FaradayRF/FaradayRF-Hardware/README.md

# FaradayRF-Hardware
This repository contains all necessary hardware files to build a Faraday radio. The design files include any engineering calculations as well as Kicad schematic, PCB, and library files.

## Kicad
Faraday was designed using the open source EDA tool Kicad. The specific version is listed below:
Version: (2013-07-07 BZR 4022)-stable

# Design Files
 * [Kicad Project](https://github.com/FaradayRF/FaradayRF-Hardware/blob/master/Kicad-Faraday/Faraday.pro)
 * [PDF Schematic](https://github.com/FaradayRF/FaradayRF-Hardware/blob/master/Kicad-Faraday/OutputFiles/FaradayRF-SCH.pdf)
 * [Fabrication Zip](https://github.com/FaradayRF/FaradayRF-Hardware/blob/master/Kicad-Faraday/OutputFiles/Faraday-RevD-FAB.zip)
   * Gerbers
   * Readme file
 * [Assembly Zip](https://github.com/FaradayRF/FaradayRF-Hardware/blob/master/Kicad-Faraday/OutputFiles/Faraday-RevD-ASSY.zip)
   * Top/Bottom copper, soldermask, solderpaste gerbers
   * Pick and place file
   * Readme file
  * [Bill of Materials](https://github.com/FaradayRF/FaradayRF-Hardware/blob/master/Kicad-Faraday/OutputFiles/Faraday-REVD(BOM).xlsx)
