FaradayRF/FaradayRF-Hardware/EngineeringDocs/ICD_REV_C.xlsx

Sheet: CC430 IO
PIN Name | Direction | Name | Function |  | Option
P1.0 | INPUT | GPS_PPS | GPS | Interrupt Enabled | GPS PPS
P1.1 | OUTPUT | UCB0CS2 | SPI | Interrupt Enabled
P1.2 | INPUT | UCB0_SOMI_SCL | SPI | Interrupt Enabled
P1.3 | OUTPUT | UCB0_SIMO_SDA | SPI | Interrupt Enabled
P1.4 | OUTPUT | UCB0CLK | SPI | Interrupt Enabled
P1.5 | INPUT | UCA0RXD | UART | Interrupt Enabled
P1.6 | OUTPUT | UCA0TXD | UART | Interrupt Enabled
P1.7 | INPUT | BUTTON_1 | IO/BTN | Interrupt Enabled
P2.0 | INPUT | GPS_UART_TX | GPS | Interrupt Enabled
P2.1 | ADC | ADC_6 | CC430_ADC | Interrupt Enabled | VCC Monitor
P2.2 | ADC | ADC_5 | CC430_ADC | Interrupt Enabled
P2.3 | ADC | ADC_4 | CC430_ADC | Interrupt Enabled
P2.4 | ADC | ADC_3 | CC430_ADC | Interrupt Enabled
P2.5 | ADC | ADC_2 | CC430_ADC | Interrupt Enabled
P2.6 | ADC | ADC_1 | CC430_ADC | Interrupt Enabled
P2.7 | ADC | ADC_0 | CC430_ADC | Interrupt Enabled
P3.0 | INPUT/OUTPUT | GPIO_2 | IO
P3.1 | INPUT/OUTPUT | GPIO_1 | IO
P3.2 | INPUT/OUTPUT | GPIO_0 | IO
P3.3 | OUTPUT | GPS_RESET | GPS
P3.4 | OUTPUT | GPS_STANDBY | GPS
P3.5 | OUTPUT | MEM_CS1 | FLASH
P3.6 | OUTPUT | LED_1 | Indicator
P3.7 | OUTPUT | LED_2 | Indicator
P4.0 | INPUT/OUTPUT | GPIO_7 | IO
P4.1 | INPUT/OUTPUT | GPIO_6 | IO
P4.2 | INPUT/OUTPUT | GPIO_5 | IO
P4.3 | INPUT/OUTPUT | GPIO_4 | IO
P4.4 | INPUT/OUTPUT | GPIO_3 | IO
P4.5 | OUTPUT | PA_ENABLE | RF
P4.6 | OUTPUT | LNA_ENABLE | RF
P4.7 | OUTPUT | HGM_SELECT | RF
P5.0 | SPECIAL | CC430_WATCH_XTAL_0 | XTAL | 32.768KHz | XIN
P5.1 | SPECIAL | CC430_WATCH_XTAL_1 | XTAL | 32.768KHz | XOUT
P5.2 | INPUT/OUTPUT | GPIO_8 | IO
P5.3 | OUTPUT | GPS_UART_RX | GPS
P5.4 | OUTPUT | MOSFET_CNTL | Actuation
P5.5 | OUTPUT | MEM_CS0 | SRAM
P5.6 | OUTPUT | MEM_HOLD0 | SRAM
P5.7 | OUTPUT | MEM_HOLD1 | FLASH

Sheet: POGO Test Points
Test Point | Function
TP1 | 3.3V
TP2 | 5V
TP3 | VCC
TP4 | VCC EXTERNAL
TP5 | AD0
TP6 | AD1
TP7 | AD2
TP8 | AD3
TP9 | AD4
TP10 | AD5
TP11 | IO0
TP12 | IO1
TP13 | IO2
TP14 | IO3
TP15 | IO4
TP16 | IO5
TP17 | IO6
TP18 | IO7
TP19 | IO8
TP20 | GPS PPS
TP21 | GPS Fixed
TP22 | MOSFET IN
TP23 | BUTTON

Sheet: PINS
PIN Number | Name | Status
1 | P1.7/ PM_UCA0CLK/ PM_UCB0STE/ R03 | NO
2 | P1.6/ PM_UCA0TXD/ PM_UCA0SIMO/ R13/ LCDREF | YES
3 | P1.5/ PM_UCA0RXD/ PM_UCA0SOMI/ R23 | YES
4 | LCDCAP/ R33 | NO
5 | COM0 | NO
6 | P5.7/ COM1/ S26 | YES
7 | P5.6/ COM2/ S25 | YES
8 | P5.5/ COM3/ S24 | YES
9 | P5.4/ S23 | YES
10 | VCORE | NO
11 | DVCC | YES
12 | P1.4/ PM_UCB0CLK/ PM_UCA0STE/ S22 | YES
13 | P1.3/ PM_UCB0SIMO/ PM_UCB0SDA/ S21 | YES
14 | P1.2/ PM_UCB0SOMI/ PM_UCB0SCL/ S20 | YES
15 | P1.1/ PM_RFGDO2/ S19 | YES
16 | P1.0/ PM_RFGDO0/ S18 | NO
17 | P3.7/ PM_SMCLK/ S17 | YES
18 | P3.6/ PM_RFGDO1/ S16 | YES
19 | P3.5/ PM_TA0CCR4A/ S15 | YES
20 | P3.4/ PM_TA0CCR3A/ S14 | YES
21 | P3.3/ PM_TA0CCR2A/ S13 | YES
22 | P3.2/ PM_TA0CCR1A/ S12 | YES
23 | P3.1/ PM_TA0CCR0A/ S11 | YES
24 | P3.0/ PM_CBOUT0/ PM_TA0CLK/ S10 | YES
25 | DVCC | YES
26 | P4.7/ S9 | YES
27 | P4.6/ S8 | YES
28 | P4.5/ S7 | YES
29 | P4.4/ S6 | YES
30 | P4.3/ S5 | YES
31 | P4.2/ S4 | YES
32 | P4.1/ S3 | YES
33 | P4.0/ S2 | YES
34 | P5.3/ S1 | YES
35 | P5.2/ S0 | YES
36 | RF_XIN | YES
37 | RF_XOUT | YES
38 | AVCC_RF | YES
39 | AVCC_RF | YES
40 | RF_P | YES
41 | RF_N | YES
42 | AVCC_RF | YES
43 | AVCC_RF | YES
44 | RBIAS | YES
45 | GUARD | YES
46 | PJ.0/ TDO | YES
47 | PJ.1/ TDI/ TCLK | YES
48 | PJ.2/ TMS | YES
49 | PJ.3/ TCK | YES
50 | TEST/ SBWTCK | NO
51 | ~RST~/NMI/SBWTDIO | NO
52 | DVCC | YES
53 | AVSS | YES
54 | P5.1/ XOUT | YES
55 | P5.0/ XIN | YES
56 | AVCC | YES
57 | P2.7/ PM_ADC12CLK/ PM_DMAE0/ CB7 (/A7) | YES
58 | P2.6/ PM_ACLK/ CB6 (/A6) | YES
59 | P2.5/ PM_SVMOUT/ CB5 (/A5/ VREF+/ VeREF+) | YES
60 | P2.4/ PM_RTCCLK/ CB4 (/A4/ VREF-/ VeREF-) | YES
61 | P2.3/ PM_TA1CCR2A/ CB3 (/A3) | YES
62 | P2.2/ PM_TA1CCR1A/ CB2 (/A2) | YES
63 | P2.1/ PM_TA1CCR0A/ CB1 (/A1) | YES
64 | P2.0/ PM_CBOUT1/ PM_TA1CLK/ CB0 (/A0) | YES
65 | VSS – Exposed pad | YES

Sheet: GPIO_Bitmask
 |  |  |  |  |  |  |  | Inputs
Hardware Defined OUTPUT's |  |  |  |  | Outputs |  |  | P1.0 | INPUT | GPS_PPS
GPIO OUTPUT Bitmask Array Byte | GPIO Bitmask Array Byte | Allocation Name | Port Allocation | Notes | P1.1 | OUTPUT | UCB0CS1 | P1.2 | INPUT | UCB0_SOMI_SCL
0 | 0 | UCB0CS1 | P1.1 |  | P1.3 | OUTPUT | UCB0_SIMO_SDA | P1.5 | INPUT | UCA0RXD
0 | 1 | UCB0_SIMO_SDA | P1.3 |  | P1.4 | OUTPUT | UCB0CLK | P1.7 | INPUT | BUTTON_1
0 | 2 | UCB0CLK | P1.4 |  | P1.6 | OUTPUT | UCA0TXD | P2.0 | INPUT | GPS_UART_TX
0 | 3 | UCA0TXD | P1.6 |  | P3.0 | OUTPUT | PA_ENABLE | P3.5 | INPUT | GPS_FIX_INDICATOR
0 | 4 | PA_ENABLE | P3.0 |  | P3.1 | OUTPUT | LNA_ENABLE
0 | 5 | LNA_ENABLE | P3.1 |  | P3.2 | OUTPUT | HGM_SELECT
0 | 6 | HGM_SELECT | P3.2 |  | P3.3 | OUTPUT | GPS_RESET
0 | 7 | GPS_RESET | P3.3 |  | P3.4 | OUTPUT | GPS_STANDBY
1 | 8 | GPS_STANDBY | P3.4 |  | P3.6 | OUTPUT | LED_1
1 | 9 | LED_1 | P3.6 |  | P3.7 | OUTPUT | LED_2
1 | 10 | LED_2 | P3.7 |  | P5.4 | OUTPUT | MOSFET_CNTL
1 | 11 | MOSFET_CNTL | P5.4 |  | P5.5 | OUTPUT | SRAM_CS
1 | 12 | SRAM_CS | P5.5 |  | P5.6 | OUTPUT | SRAM_HOLD
1 | 13 | SRAM_HOLD | P5.6
1 | 14 | TBD
1 | 15 | TBD
Hardware Defined Input |  |  |  |  | GPIO
GPIO INPUT Bitmask Array Byte | GPIO Bitmask Array Byte | Allocation Name | Port Allocation |  | P4.0 | TBD | GPIO_7
0 | 0 | GPS_PPS | P1.0 |  | P4.1 | TBD | GPIO_6
0 | 1 | UCB0_SOMI_SCL | P1.2 |  | P4.2 | TBD | GPIO_5
0 | 2 | UCA0RXD | P1.5 |  | P4.3 | TBD | GPIO_4
0 | 3 | BUTTON_1 | P1.7 |  | P4.4 | TBD | GPIO_3
0 | 4 | GPS_UART_TX | P2.0 |  | P4.5 | TBD | GPIO_2
0 | 5 | GPS_FIX_INDICATOR | P3.5 |  | P4.6 | TBD | GPIO_1
0 | 6 |  |  |  | P4.7 | TBD | GPIO_0
0 | 7
Hardware Defined GPIO
GPIO INPUT Bitmask Array Byte | GPIO Bitmask Array Byte | Allocation Name | Port Allocation
0 | 0 | GPIO_7 | P4.0
0 | 1 | GPIO_6 | P4.1
0 | 2 | GPIO_5 | P4.2
0 | 3 | GPIO_4 | P4.3
0 | 4 | GPIO_3 | P4.4
0 | 5 | GPIO_2 | P4.5
0 | 6 | GPIO_1 | P4.6
0 | 7 | GPIO_0 | P4.7

Sheet: ADC Memory Registers
ADC Memory | REF_LOW | REF_HIGH | ADC Channel | Faraday Channel | Port Pin | Note
ADC12MCTL0 | GND | Internal 2.5V Reference | AD_0 | Analog 7
ADC12MCTL1 | GND | Internal 2.5V Reference | AD_1 | Analog 6
ADC12MCTL2 | GND | Internal 2.5V Reference | AD_2 | Analog 5
ADC12MCTL3 | GND | Internal 2.5V Reference | AD_3 | Analog 4
ADC12MCTL4 | GND | Internal 2.5V Reference | AD_4 | Analog 3
ADC12MCTL5 | GND | Internal 2.5V Reference | AD_5 | Analog 2
ADC12MCTL6 | GND | Internal 2.5V Reference | AD_6 | Analog 1
ADC12MCTL7 | GND | Internal 2.5V Reference | AD_10 | MSP430 Temperature | Internal Temperature
ADC12MCTL8 | GND | Internal 2.5V Reference | AD_11 | MSP430 3.3V Vin | 3.3V | (AVCC-AVSS)/2
