FaradayRF/FaradayRF-Hardware/EngineeringDocs/Crystal_Calculations.xlsx

ABM8G-26.000MHZ-18-D2Y-T
CL | 18 | pF
CStray | 3 | pF | Assumption
C1 | 30 | pF
C2 | 30 | pF
Ccalc | 18 | pF
ST3215SB32768H5HPWAA
CL | 12.5 | pF
CStray | 3 | pF | Assumption
C1 | 18 | pF
C2 | 18 | pF
Ccalc | 12 | pF
