FaradayRF/FaradayRF-Hardware/EngineeringDocs/RF_Power_Test_RevB_11-19-2016.xlsx

CC430 Setting | Power Indicated | Power (dBm)
1 | -17.18 | -7.18
5 | -10.59 | -0.59
20 | -5.81 | 4.19
30 | 1.8 | 11.8
40 | 5.8 | 15.8
50 | 0.27 | 10.27
60 | 12.34 | 22.34
70 | 13.06 | 23.06
80 | 13.77 | 23.77
90 | 13.2 | 23.2
100 | 12.18 | 22.18
120 | 13.9 | 23.9
130 | 15.68 | 25.68
140 | 14.51 | 24.51
145 | 15.67 | 25.67
150 | 15.28 | 25.28
155 | 14.74 | 24.74
165 | 15.38 | 25.38
175 | 7 | 17
185 | 14.9 | 24.9
