FaradayRF/FaradayRF-Hardware/CHANGES.txt

# Please include a list of the changes you made to the original design by FaradayRF below
# Per TAPR OHL V1.0
