FaradayRF/FaradayRF-Hardware/(threads)

Thread 1 (2016-10-17):

Update Hardware From Revision B Design/Testing

kb1lqc, 2016-10-17:
Revision B hardware testing has identified several changes that would be ideal to incorporate with a board spin. Most of these are manufacturing related to help ensure a well designed PCB for production.

- [x] Change L10 to 22nH 0603 inductor
- [x] Check NUF2101MT1G (U10) footprint carefully
- [x] Check MIC94072YC6 (U12) footprint as it looks very close to solder bridge prone
- [x] Move Via near CC430 exposed pad which causes copper to be pulled back
- [x] Put Solder paste Layer on Q1
- [x] Double-check orientation of X2 versus datasheet and footprint/pinout
- [x] Consider changing R17 to 360 Ohms for stronger filter
- [x] Remove an RC filter from an ADC port to allow microphone use
- [x] Map GD0 to a pin for eventual use off-board @kb1lqd overview in #6
- [x] Validate USB Multiplexing & Negotiation Circuitry
- [x] Make sure antenna is located such that it doesn't hit DOUT headers
- [x] Verify flash memory hardware @kb1lqd
- [x] Update silkscreen markings to Rev C
- [x] Update Faraday logo + open logo
- [x] Crystal X2 silkscreen pin 1 indicator moved to printable area
- [x] Keep copper out of CC1190 keepout area
- [x] Pull back copper from C28 and C9

kb1lqc, 2016-10-18:
**Remove an RC filter from an ADC port to allow microphone use**

I have decided to remove ADC5 RC filter to allow use with a microphone or other needs for unaltered ADC input. To do this, I've simply placed a 2 Ohm resistor at R25 and DNP'd C48. This allows eventual modification to a normal RC low-pass filter or just a capacitor in place of R25 to create a high-pass filter if speech recognition is benefited from that. Using 2 Ohms essentially gives me a zero Ohm resistor without adding a BOM line item.

Frc = 1/(2*Pi*(2 Ohms) * (25pF)) = 3.18 GHz

The resonant frequency of the 2 Ohm jumper with the CC430 ADC input capacitance of 25 pF creates a low-pass filter at 3.18 GHz which means the CC430 will be unaffected by this resistor.

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

kb1lqc, 2016-10-18:
**Put Solder paste Layer on Q1**
I actually cannot see why this came up as an issue. Looking at the actual OSHStencil Q1 clearly has holes for solderpaste. The KiCad PCBNew module editor also clearly shows Q1 having "Front Solder Paste" layers on each pad.

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

Looking at the image I took of a Faraday Rev B PCB just after solderpaste application clearly shows Q1 not covered in solder paste. I think the culprit is that either I didn't push down hard enough with the squeegee card when applying solderapaste or the holes are too small.

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

Marking this is complete. Production boards will be professionally pick and placed.

kb1lqc, 2016-10-18:
**Consider changing R17 to 360 Ohms for stronger filter**
I hooked up a Faraday Rev B to an old HP 6205C bench PSU and set the voltage to 1.395V. Faraday vin reads up to about 2.41V with it's internal Vref so this is roughly in the middle of the range. The HP power supply is also not the quietest supply, especially with almost no load.

Capturing roughly 30 minutes of telemetry I observed on average 2 bits of noise. The peak noise of the 1Hz telemetry appears to be about +-3 bits. Using an internal CC430 Vref and not using a super stable PSU or external reverence voltage to generate a test voltage I'm considering the CC430 ADC's to work well.

kb1lqc, 2016-10-18:
**Map GDO to a pin for eventual use off-board**
@kb1lqd What do you mean by bringing GDO off the board? Given the [CC430 Family User's Guide](http://www.ti.com/lit/ug/slau259e/slau259e.pdf) the GDO pin might be able to be mapped to an external pin already.

Did you want Synchronous or Asynchronous support?

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

As it stands the GDO0 pin is on P1.0 which is currently used for GPS PPS signal.

- GDO0 = GPS PPS
- GDO1 = LED 1
- GDO2 = UCB0CS2

Are you sure we can't simply use the port mapper internally to the CC430 to move GDO0 to a IO pin such as on P4.x?

kb1lqc, 2016-10-18:
**Make sure antenna is located such that it doesn't hit DOUT headers**

- This comment/concern stems from the idea that we want to stack any custom PCBs or "shields" on-top of Faraday. This is not entirely true
 - It appears that if custom boards were put on-top they could fit just without connecting to D0, D1, or D2. The PCB would simply not be able to go past D3 or it would hit the antenna/SMA connector.

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

- However this isn't an issue if we simply assume that Faraday will always be the top PCB.
- We must make custom PCB/shields anyways, while Faraday is the same form-factor as an Arduino and will physically plug into an Arduino or Arduino compatible shield, our pinout is different. This was an honest decision we made Rev A to Rev B as the Arduino pinout greatly limited us.

> Marking this as solved and doing nothing. Stack any extra boards on the bottom or if they are stacked on the top then design in a cutout for the antenna. Moving the antenna is too big of a problem give 4 layers and the amount of IO routing in that area of the board.

kb1lqc, 2016-10-19:
**Validate USB Multiplexing & Negotiation Circuitry**

To check this circuit out I need to perform the following hardware changes
- DNP R7
- Populate U11
- Populate C15

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

Then I will need to configure the FTDI [FT PROG](http://www.ftdichip.com/Support/Utilities.htm#FT_PROG) to configure CBUS3 of U6 to be Power Enable. This will auto-configure into high power mode before turning on Faraday when plugged into a USB port. It's advantageous since this is USB compliant and overall causes less inrush.

kb1lqc, 2016-10-20:
Per my testing on #5 I've decided to use the FTDI USB negotiation and soft-start circuit. This ensures we are conservative with USB power on and minimize inrush events that could damage Faraday or damage a USB port powering Faraday.

I've removed R7 and populated C15 and U11 to perform the inversion necessary to have the FT230X control the MIC94072YC6.

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

kb1lqc, 2016-10-20:
**Move Via near CC430 exposed pad which causes copper to be pulled back**
Offending via shown below from Rev B build images
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

This is the GPS standby control signal. So low speed on/off and therefore can be routed however I need.
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

## Fixed
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

As shown above I routed the standby signal as well as two adjacent signals (HRST, P3_6) to move STDBY up to 15 mils from the CC430 center exposed pad. This should fix any issue of the copper being pulled back for the via.

kb1lqc, 2016-10-21:
# Check NUF2101MT1G footprint carefully

Looking at it I can't see what I thought was wrong? Looks fine... U10:
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

Comparing to the datasheet suggested land pattern:
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

## Pad Size
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

- Looks like the length Y is a bit longer than suggested but that's not really an issue here.
- X width is smaller than suggested
- all axis rotated 90 degrees so Y is left to right in footprint compared to my library footprint

This is likely due to me basing my footprint on one particular suggested footprint which differs from another vendor. This in general shouldn't be an issue for standard footprints such as this TSOP-6.

Checking pad spacing the Y spacing between pads it looks fine at 0.95mm. The X spacing is a little wide at 2.62mm but that's well within reason for having slightly longer pads to make up for that. This part will fit squarely on these pads.

kb1lqc, 2016-10-21:
# Check MIC94072YC6 (U12) footprint as it looks very close to solder bridge prone

U12 looks like it's a bit close to shorting between pins. There's almost no soldermask between pins! Maybe this is OK but whew...

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

## Footprint
This footprint is based on the Linear Technology [footprint for a SC70-6](http://cds.linear.com/docs/en/packaging/SOT_6_05-08-1638.pdf).

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

Pad Y: 1.00mm
Pad X: 0.47mm

This is exactly what the footprint wants. So looking at spacing now:

Pad Y Spacing: 1.8mm
Pad X Spacing: 0.65mm

This is also exactly what the LTC footprint asks for, copper looks good.

## Soldermask
It looks like OSHPark, who made the Rev B boards, has a minimum of 2.5 mil soldermask sliver for their prototype 4 layer boards. See their [specs](http://docs.oshpark.com/services/four-layer/). I'm going to assume OSHPark doesn't use a fancy process to make their boards (safe assumption) which means 2.5mils is 0.0635mm.

I measured 0.178mm between pads on my footprint model.
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

When looking at the PCB prior to populating it, the pads of U12 seem fine, there's a decent amount of soldermask there. I may see better results when the proper amount of solderpaste is applied, I likely used too much.

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

kb1lqc, 2016-10-21:
# Double-check orientation of X2 versus datasheet and footprint/pinout

The 26 MHz crystal, X2, on Faraday was originally placed backwards. This crystal is the [/ABM8G-10572](http://www.mouser.com/ds/2/3/ABM8G-10572.pdf). Here's the position on the board design:
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

and here is my initial placement which was 90 degrees off:
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

The top view looking down through the package as if the ceramic wasn;t present we should expect this pinout:
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

## Conclusion
It's obvious that my footprint agrees with the top view as it should, my orientation on the board is 180 degrees different but rotating the suggested footprint would result in the exact same, and correct, placement as I realized after populating the board.

Now why did I think I was right when populating at 90 degrees off? It appears that the chamfer can switch betwee pin 1 and pin 4, if the chamfer was on pin 4 instead of pin one then I would absolutely have placed the crystal the way I did.
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

## Solution
So this then comes down to not judging orientation by the chamfer. Instead if I simply ensure that my library footprint is [compliant with IPC-7351 Level A](https://blogs.mentor.com/tom-hausherr/blog/tag/ipc-standards/) then there is no need to look for the chamfer,
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

Keeping this orientation standard and using a pick and place machine results in either pin 1 being placed on pad 1 or with 180 degrees rotation in the tape and reel pin 3 would be placed on pad 1. This however is completely fine as pin 1 would connect to pad 3 and that still connects the crystal correctly.

Looking at my library I have pin 1 in the upper left quadrant 1 of the IPC spec. The datasheet shows the tape and reel orientation with long edges vertical when holding tape horizontal. According to the Mentor Graphics blog post oscillators (multi-pin) are in tape and reel packages with pin 1 in the lower left quadrant.

It seems like this is purely up to me telling the manufacturer that I follow IPC-7351 Level A with my footprints and that they should observe good judgment on tape an reel orientations. Worst-case the first batch of boards needs to be reworked and this is a pretty easy part to rework with a heat gun.

kb1lqc, 2016-10-24:
#  Map GD0 to a pin for eventual use off-board

Looking into this from @kb1lqd comments on #6, I will be using that Issue Ticket to track changes to the PCB. This is looking like it will absolutely be the biggest change to the entire board between Rev B and Rev C...

kb1lqc, 2016-10-25:
Confirming successful changes to Revision C hardware

- [x] Change L10 to 22nH 0603 inductor
_Inductor moved over to L0603 footprint_
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

- [x]  Check NUF2101MT1G (U10) footprint carefully
_Part looks fine on board_
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
- [x]  Check MIC94072YC6 (U12) footprint as it looks very close to solder bridge prone
_Checked out fine in previous comment about this footprint_
- [x]  Move Via near CC430 exposed pad which causes copper to be pulled back
_Looks good to me, my moved pulled it away from the pad even with further work in the area_
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
- [x]  Put Solder paste Layer on Q1
_Q1 is correctly solderpasted_
- [x]  Double-check orientation of X2 versus datasheet and footprint/pinout
_Orientation is fine per pin 1 having the chamfer. Professional pick and place should remove human eye coordination error._
- [x]  Consider changing R17 to 360 Ohms for stronger filter
_Keeping 2 Ohm resistor with standard 0.1uF decoupling capacitor. No need to change._
- [x]  Remove an RC filter from an ADC port to allow microphone use
_ADC5 replaced series resistance with 2 Ohm resistor while parallel capacitor DNP'd_
- [x]  Map GD0 to a pin for eventual use off-board @kb1lqd overview in #6

 - Pin 22: DIGITAL_IO_0
 - Pin 23: DIGITAL_IO_1
 - Pin 24: DIGITAL_IO_2
 - Pin 26: HGM_Select
 - Pin 27: LNA_Enable
 - Pin 28: PA_Enable

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

- [x]  Validate USB Multiplexing & Negotiation Circuitry
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
- [x]  Make sure antenna is located such that it doesn't hit DOUT headers
_Antenna nor does RF SMA cable become obstructed by IO headers when installed._
- [x]  Verify flash memory hardware @kb1lqd
@kb1lqd brought up the flash and was able to fix a [few initial errors](https://github.com/FaradayRF/Faraday-Firmware/issues/10) in his firmware to get it shaken out.
- [x]  Update silkscreen markings to Rev C
_Complete_
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
- [x]  Update Faraday logo + open logo
_Complete_
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

kb1lqc, 2016-10-25:
Checked all updates. Appear OK. Closing.

kb1lqc, 2016-10-26:
Documenting that running a Freedfm.com test caught a soldermask pullback error! The 0603 L10 component I placed in the CC1190 section is apparently missing a soldermask relief on the soldermask gerbers:

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

Yup, clearly visible. Will update!
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

kb1lqc, 2016-10-27:
Reopened to document several recent updates.

**X2 footprint updated to let Pin 1 silkscreen indicator print on PCB**
Was previously under pin 1 on C9 so it would never print
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

**U4 CC1190 Keepout Area Copper Pour Removed**
L10 moving to 0603 let copper pour under the keepout area. While this is fine, I want to not let this change happen from Rev B to Rev C.

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

**Copper Ground near C28 and L9 Pulled Back**
As shown in the image above of U4, you can see that the copper ground pour on the top layer no longer tries to fill in between the pads. I decided to keep the path of RF clear of any encroachments.

Closed 2016-10-27.

Thread 2 (2016-10-17):

Panelize PCB Design

kb1lqc, 2016-10-17:
Create standard panels with Faraday on them to reduce manufacturing costs, increase build efficiency, and increase yield.
- Panels should be sized such that more than one manufacturer can produce them
- Fiducials shall be placed on both unit PCBs and rails

Most work shall be completed in the [Production branch](https://github.com/FaradayRF/FaradayRF-Hardware/tree/Production) until it is ordered, then it will be moved over to Master.

kb1lqc, 2016-11-02:
Closing this until necessary, it appears most fabrication houses still tend to do this themselves.

Closed 2016-11-02.

Thread 3 (2016-10-17):

Move Hardware Files From SVN to GitHub

kb1lqc, 2016-10-17:
Reorganize the libraries and get the KiCAD 2013 project files to produce a correct ERC and DRC run on a standalone GitHub repository.

kb1lqc, 2016-10-17:
Closed issue as commit e1ad8f953297278cf41e22684335b58808a117df successfully brought the Revision B hardware files into GitHub!

Closed 2016-10-17.

Thread 5 (2016-10-19):

USB Power Testing

kb1lqc, 2016-10-19:
Testing performed to validate the design of the 5V USB power supply inrush limiting and USB compliance. Essentially, it's in our best interest to prevent Faraday from causing an inrush event when plugged in and ringing to over-voltage and destroy itself :white_check_mark:

kb1lqc, 2016-10-19:
I placed all my oscilloscope captures and a description PDF file into the Production branch Engineering Documents folder:

https://github.com/FaradayRF/FaradayRF-Hardware/tree/Production/EngineeringDocs/Oscilloscope_Captures/USB_Power_Testing

kb1lqc, 2016-10-19:
# 5V Input Transient
When connecting a Faraday to USB a rising edge inrush event occurs which will cause ringing with the capacitance and inductance on Faraday. The image below shows this inrush event measured with a low inductance ground lead for maximum signal accuracy.

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
-  Channel 1: Pin 1 of P16, microUSB connector VCC

Looking past ferrite bead Z2 we can see what signal the 5V rail of Faraday experiences
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
-  Channel 1: +5V Rail on Faraday

kb1lqc, 2016-10-19:
# MIC94072YC6 Performance
U12 limits inrush current by linearly turning on over the course of just about 1ms. This limits the charging current of bulk capacitance such as C17. All tests here performed with standard oscilloscope 6" ground clips to ground.

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
- Channel 1: +5V Rail
- Channel 2: Q3 Pin 3 (input to ideal diode)
It obvious that the IC works and took about 650uS to turn on which is pretty decent. Current into C17 certainly would be limited. The overvoltage spike present on the 5V rail does not make it past the ideal diode Q3.

For record, I plugged a 9V battery into Faraday via the VCC connector and then plugged in USB. As expected almost no current is drawn from USB so both +5V rail and Q3 pin 3 rise quickly as little voltage is dropped across U12 as it turns on.
- Channel 1: +5V Rail
- Channel 2: Q3 Pin 3 (input to ideal diode)
- Channel 3: C17 voltage to ground

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

I also performed a test where I left the 5V USB cable plugged in but then attached the 9V battery causing the ideal diode U2 (LTC3312) to reverse bias allowing the 9V to take over powering Faraday seamlessly. Same oscilloscope channel connections.
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

## USB Power to TPS562201DDCR Vin
A full end-to-end test showing the turn-on of power to U3 TPS562201 regulator input.

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
- Channel 1: +5V Rail
- Channel 2: Q3 Pin 3 (input to ideal diode)
- Channel 3: C17 voltage to ground

It's clear that the inrush current is in-fact limited and soft-start works well. Not totally sure it's USB compliant but it's a good effort for sure.

kb1lqc, 2016-10-19:
# FTDI FT230X CBUS PWREN Function
The FTDI FT230X allows you to use FT PROG to program the CBUS pin functions. Therefore I populated U11 and C15 while DNP R7 to allow CBUS3 to control the inrush limiter U12.

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

The scope capture below shows the USB negotiation occurring which after about 200ms the FT230X commands CBUS3 to enable U12 on. It's working!
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
- Channel 1:+5V
- Channel 2: Q3 pin 3
- Channel 3: VCC V17 voltage to GND

Zooming out a bit it's apparent the computer is generating some noise on Channel 1 (yellow) and after roughly four seconds it settles down. It does not appear that the noise makes it passed the ideal diode into C17, or it's at least filtered out a bit.
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
- Channel 1:+5V
- Channel 2: Q3 pin 3
- Channel 3: VCC V17 voltage to GND

Finally moving into a zoomed in position to take a look at the turn-on even when the FTDI FT230X enables the USB high power to occur. It's apparent that the output of U12, Q3 pin 3 and C17 float up to about 2V given U12 has some leakage current through it even when it's off.
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
- Channel 1:+5V
- Channel 2: Q3 pin 3
- Channel 3: VCC V17 voltage to GND

kb1lqc, 2016-10-19:
# Important Note About USB Power Negotiation
:exclamation: I realized that if Faraday uses USB negotiation then when it is plugged into a USB battery pack there is no computer to negotiate with.

Testing this with my Goal Zero Lighthouse Mini (lantern with USB output) I definitely see about 2V across C17 even well after turn-on. This configuration prevents Faraday from working with USB battery packs, however, 9V batteries on VCC would work fine.

kb1lqc, 2016-10-20:
I tested the leakage of the MIC94072YC6 when commanded to be off. To do this I plugged it into my Goal Zero USB battery pack which does not perform USB negotiation.

U12 Pin 3: 5.1V
U12 Pin 4 5.1V
U12 Pin 1: 1.395V

Clearly the MIC94072YC6 is being commanded off but it is not fully off. When I short Q3 pin 3 to ground through a multimeter I measure about 11mA which is not what the datasheet says it should be doing. Interesting.

kb1lqc, 2016-10-20:
> OK after much thought I'm going to keep the MIC94072YC6 and LTC4412 but use the USB configuration method. U12 seems capable of leaking 11mA when commanded off which could be a measurement error by me (poor solder?) but regardless this isn't an issue as we do not plan to support USB battery packs when 9V batteries are easily supported.

## USB 2.0 Inrush Specification
[USB Inrush Current](http://www.testusb.com/inrush_issue.htm) is nicely worded at the provided link. Faraday by design will initially place 1.3uF of capacitance on the VUSB pin to GND when attached. This is well below the 10uF limit and while I don't have the equipment to test inrush this is a good indicator that Faraday would pass.

Roughly 250ms after connection to power as shown below, Faraday negotiates into PWREN mode from the FT230X which turns on U12 allowing the >10uF present downstream from U12 to be connected to USB power with a ~800uS turn on soft-start. The USB specification requires no device to sink more than 100mA after inrush for at least 100ms which means by design Faraday is compliant with this USB 2.0 power specification.

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

## Automatic Power Detection
It's worth noting that the USB specification actually requires at least 1uF capacitance on VBUS in Section 7.2.4.2 so that a minimum inrush event is guaranteed. This allows devices to be detected if they are connected so they can turn on the circuitry that is powering the peripheral such as Faraday.

kb1lqc, 2016-10-20:
Completed my USB and power multiplexing tests I intended on this issue. I performed others off the record prior to starting this GitHub to ensure proper design as well.

Closed 2016-10-20.

Thread 6 (2016-10-23):

Synchronous/Asynchronous CC430 Radio Support

kb1lqd, 2016-10-23:
# Overview
It is likely that in the future Faraday will split into two main projects:
- A smart node digital radio with radio and communication processes controls on the CC430
- A (mostly) dumb radio module that allows a more powerful processor perform the communications such as a Raspberry Pi. Interactions with Faraday in this mode would largely be that of a raw modem interface through UART/SPI/CC1101 GDx pins

Texas Instruments provides a basic overview of the radio operations possible with the CC430: [http://www.ti.com/lit/an/slaa465c/slaa465c.pdf](http://www.ti.com/lit/an/slaa465c/slaa465c.pdf)

The example RF code is located here: [http://www.ti.com/lit/zip/slac525](http://www.ti.com/lit/zip/slac525)

## Actions

Since all the default port mapping is used for RF GDx pins and it's a secondary function we should implement port mapping. Port mapping is supported on P1, P2, and P3. We should swap 3 of the GPIO pins using port 4 with port 3 pins to allow a GPIO pin to become an RF GD0 pin.

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

Swap with basic I/O pins used on GPS and other devices:

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

Recommend swapping:

4.0 <-> 3.2
4.1 <-> 3.3
4.2 <-> 3.4

This **Should** allow for low risk swapping and peripheral operation while allowing a port mapped GDx signals to the external pins.

# Details

## Hardware Packet Handling (Less Than/Greater Than FIFO)

No changes needed, all of this is handled in the firmware. Key points:

- Really simple 64 byte FIFO operation
- Capability to have unlimited packet size operation
- Must still use general packet hardware structure and sync headers

## Synchronous/Asynchronous Operations

Synchronous/Asynchronous operation allows for direct access to the CC1101 radio core. This allows for the most flexibility in radio protocols as well as the ability to perform low level protocol processing on a more powerful platform.

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

### Asynchronous

Requires the use of internal timers.

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

### Synchronous

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

# Port Mapping

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

# Radio GD0 Pins

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

# Examples

Clock timer output to 2.7
Data output 2.6

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

The CC430 header file snippet above shows Port 3 but Port 2 is the same.

kb1lqc, 2016-10-24:
Upon inspection, I'd much rather use signals already traveling to the general CC1190 and GPIO pin area so I minimally affect my routing scheme. This means initially I'd like to perform the following IO changes:

- P3.0 to P4.5
- P3.1 to P4.6
- P3.2 to P4.7

This forces the CC1190 control signals to be moved over to GPIO channels. Since these signals generally route to the same area of the PCB this then results in minimal impact to the design.

kb1lqd, 2016-10-24:
@kb1lqc OK that makes sense. I should double check that all P4 GPIO do infact work as intended.

kb1lqc, 2016-10-24:
OK I updated and swapped the mentioned P3 and P4 signals. This was much easier to route since the channels all went to the same area of the PCB. This was changed in 4786a6094c6b3ada832c1a492106f61978195773.

kb1lqc, 2016-10-27:
Closing this issue as it was addressed in Issue #1

Closed 2016-10-27.

Thread 7 (2016-10-24):

Update Bill Of Materials For Rev C

kb1lqc, 2016-10-24:
KiCad provides a CSV output for the BOM but it needs to be updated to the latest changes. This should not be affected by panelization.

kb1lqc, 2016-10-24:
Updated most components in Rev C BOM to reflect the actual design as it currently stands. https://github.com/FaradayRF/FaradayRF-Hardware/commit/b83846a14831a8f30512f1a6c8d7647d2e71f8d7 holds the most current status of the BOM which needs a few more items actually sourced from vendors.

kb1lqc, 2016-10-27:
Updated a few components such as L10 and changed USB cable to one from Amazon.

Closed 2016-10-27.

Thread 8 (2016-10-26):

Validate Rev C Gerbers

kb1lqc, 2016-10-26:
Check Rev C Gerbers against Rev B Gerbers to make sure any and all differences are accounted for. The quickest way to do this is to use GerbV to XOR Rev B and Rev C, leaving the differences highlighted.

- [x] Faraday.drl
- [x] Faraday-B_Cu.gbl
- [x] Faraday-B_Mask.gbs
- [x] Faraday-B_Paste.gbp
- [x] Faraday-B_SilkS.gbo
- [x] Faraday-drl_map.pho
- [x] Faraday-Dwgs_User.gbr
- [x] Faraday-Eco1_User.gbr
- [x] Faraday-Eco2_User.gbr
- [x] Faraday-Edge_Cuts.gbr
- [x] Faraday-F_Cu.gtl
- [x] Faraday-F_Mask.gts
- [x] Faraday-F_Paste.gtp
- [x] Faraday-F_SilkS.gto
- [x] Faraday-InnerA_Cu.gbr
- [x] Faraday-InnerB_cu.gbr
- [x] Faraday-NPTH.drl
- [x] Faraday-NPTH-drl_map.pho

kb1lqc, 2016-10-26:
**Faraday.drl**
Differences from Rev B to Rev C
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

- It's clear that the only holes to change were related to the via's moved around to route the RF control signal lines and GPIO lines for GD0, GD1, and GD2. These changes moved lines for
 - P3.0, P3.1, P3.2, P4.5, P4.6, P4.7

_Faraday.drl looks good_

kb1lqc, 2016-10-26:
**Faraday-B_Cu.gbl**

Rev B to Rev C differences
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

- It appears that only the area involving the GDx signals between P3 and P4 on the MSP430 moved.
- Honestly, I think Rev C looks cleaner! (orange)

_Faraday-B_Cu.gbl looks good_

kb1lqc, 2016-10-26:
**Faraday-B_Mask.gbs**
Changes from Rev B to Rev C
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
- No observable changes for bottom soldermask which is good because I didn't change anything that would affect that.

_Faraday-B_Mask.gbs looks fine_

kb1lqc, 2016-10-26:
**Faraday-B_Paste.gbp**
Rev B to Rev C changes
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
 - No observable changes, changed nothing.

_Faraday-B_Paste.gbp looks good_

kb1lqc, 2016-10-26:
**Faraday-B_SilkS.gbo**
Rev B to Rev C changes
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
- FaradayRF and Rev B changed
 - This is ideal since I moved both texts to the front silkscreen and updated Rev b to Rev C

_Faraday-B_SilkS.gbo looks good_

kb1lqc, 2016-10-26:
**Faraday-drl_map.pho**
Rev B to Rev C changes
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
- Only drill holes associated with GDx pin changes observed as expected.

_Faraday-drl_map.pho looks good_

kb1lqc, 2016-10-26:
**Faraday-Dwgs_User.gbr**
Rev B to Rev C changes
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
- No changes to the drawing data as expected.

_Faraday-Dwgs_User.gbr looks good_

kb1lqc, 2016-10-26:
**Faraday-Eco1_User.gbr**
Rev B to Rev C changes
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
- Compenent courtyards for several devices changed.
 - Removed R7 near power supply previously used for soft-start enable switching
 - Changed out L10 near CC1190 circuit from 0402 to an 0603 component. Also had to move an adjacent part sideways slightly to fit the larger package.

_Faraday-Eco1_User.gbr looks good_

kb1lqc, 2016-10-26:
**Faraday-Eco2_User.gbr**
Rev B to Rev C changes
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

- No observable changes, good since I didn't change anything on this layer which is the path of the drill bit used to cut the boards out with tabs.

_Faraday-Eco2_User.gbr looks good_

kb1lqc, 2016-10-26:
**Faraday-Edge_Cuts.gbr**
Rev B to Rev C changes
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
- Nothing as I did not change the board dimensions from Rev B to Rev C

_Faraday-Edge_Cuts.gbr looks good_

kb1lqc, 2016-10-26:
**Faraday-F_Cu.gtl**
Rev B to Rev C Updates
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
- Several changes observed
 - R7 near the power supply soft start on the top left of the PCB has been removed in Rev C
 - The ADC lines in the bottom right were tidied up just slightly

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
Zooming in on the RF section:
- The GPIO lines as well as RF configuration signal lines were updated to help route GDx signals.
- L10 updated to an 0603 package which did allow copper to pour under the CC1190's bottom right corner. I happen to remember this area being a keepout. However, since no exposed copper or vias are in this keepout range I don't expect any issues.
 - :exclamation: On a similar note, I now have copper pouring beneath L10 which I don't trust. I'd like to keep copper from pouring underneath inductors. Provide keepout to prevent copport from pouring below

_Faraday-F_Cu.gtl **needs updating**_

kb1lqc, 2016-10-26:
**Faraday-F_Mask.gts**
Rev b to Rev C changes
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
- It's obvious from previous comments that the only differences here are the power supply soft start resistors removal and the L10 update to an 0603 component.

_Faraday-F_Mask.gts looks good_

kb1lqc, 2016-10-26:
**Faraday-F_Paste.gtp**
Rev B to Rev C Updates
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
- Changes again only appear in the regions of the soft-start resistor removal and the L10 upgrade in the RF amplifier section

_Faraday-F_Paste.gtp looks good_

kb1lqc, 2016-10-26:
**Faraday-F_SilkS.gto**
Rev B to Rev C upgrades
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
- Changes observed line up with good edits to the board
 - R7 has been removed so the reference designator will go too
 - L10 and C30 moved, including L10 increasing to 0603 footprint.
- Faraday name and Rev. C marking moved to top-middle of PCB
- OSHW logo and Faraday logo moved to middle of board and updated.
 - Old Faraday logo removed.

_Faraday-F_SilkS.gto looks good_

kb1lqc, 2016-10-26:
**Faraday-InnerA_Cu.gbr**
Rev B to Rev C updates
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
 - Changes line-up with via's used for GDx rerouting between GPIOs and RF switches

kb1lqc, 2016-10-26:
**Faraday-InnerB_cu.gbr**

Rev B to Rev C changes
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

- Again, changes consistent with new via locations near CC430 and RF section

_Faraday-InnerB_cu.gbr looks good_

kb1lqc, 2016-10-26:
**Faraday-NPTH.drl**
Rev B to Rev C changes
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
- No observable changes for inner layer A

_Faraday-NPTH.drl looks good_

kb1lqc, 2016-10-26:
**Faraday-NPTH-drl_map.pho**
Rev B to Rev C changes
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
- No observable changes

_Faraday-NPTH-drl_map.pho looks good_

kb1lqc, 2016-10-27:
Checking top layer and silkscreen after working with pick and place files resulted in a silkscreen change on X2 and in general want to make sure my footprints didn't change unexpectedly.

# Top Layer Rev B to Rev C
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

* Overall looks like nothing changed I didn't already go over
  * R7 near power supplies
  * ADC lines tidied up
  * GPIO and RF control signals rerouted
  * Copper near L10, C28, and L9. I know I didn't pull back from C29 but signal already split and I can only be so OCD...

# Rev B to Rev C Front Silkscreen
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
* L10 appears fine and 0603 with adjacent passive moved slightly right
* R7 removed

# Rev B to Rev C Front Solderpaste
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

* Changes as expected with L10 increased to 0603 and R7 removed.
* No other footprint changes seen

# Rev B to Rev C Front Silkscreen
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

* As expected reference designators for L10 and C30 moved with increase to L0603
* Faraday logo updated and OSHW added
* Faraday Rev and name updated
* X2 pin 1 indicator dot moved

kb1lqc, 2016-10-27:
Created final gerber (non-panelized) files and checked known changes. Looks good.

Closed 2016-10-27.

Thread 9 (2016-10-27):

Check Pick and Place Files

kb1lqc, 2016-10-27:
Ensure orientation makes sense. Verify library IPC pin 1 orientation and ensure output file makes sense to rotation file. I have used this [blog post](https://blogs.mentor.com/tom-hausherr/blog/tag/ipc-standards/) from Tom Hausherr at Mentor Graphics as a guideline for my library management process.

:warning: Moved over to Faraday.mod library from old KB1LQC.mod library due to incomplete library references. This ensures latest footprints are being used and only those that are inspected hardware tested are being used.

**IPC-7351B Zero Rotation** means that two pin passives always have zero rotation with pin 1 on the left, diodes have pin 1 (cathode) on the left. IC packages always have zero rotation pin 1 located in upper left quadrant. This standard allows the assembler to relate tape and reel orientation to PCB library rotation.

# IPC-7351B Zero Rotation
- [x] C0402
- [x] C0603
- [x] R0402
- [x] L0402
- [x] L0603
- [x] L0805
- [x] RGC
- [x] RGV
- [x] LGL29K
- [x] LPS4018
- [x] 22232021
- [x] 10118192-0001LF
- [x] SOT23-NXP
- [x] TSOT23-6
- [x] SF2049E
- [x] QFN-16-4x4
- [x] M10478-A2
- [x] TSSOP8
- [x] SOIC8-150MIL
- [x] SOT753
- [x] SC70-6
- [x] 0915BM15A0001E
- [x] ST3215SB32768H5H
- [x] ABM8G

# Faraday-all.csv Orientation
Checking each type of component to make sure orientation file makes sense
- [x] C0402
- [x] C0603
- [x] R0402
- [x] L0402
- [x] L0603
- [x] L0805
- [x] RGC
- [x] RGV
- [x] LGL29K
- [x] LPS4018
- [x] 22232021
- [x] 10118192-0001LF
- [x] SOT23-NXP
- [x] TSOT23-6
- [x] SF2049E
- [x] QFN-16-4x4
- [x] M10478-A2
- [x] TSSOP8
- [x] SOIC8-150MIL
- [x] SOT753
- [x] SC70-6
- [x] 0915BM15A0001E
- [x] ST3215SB32768H5H
- [x] ABM8G

kb1lqc, 2016-10-27:
Completed all footprints look good with new Faraday.mod library.

Closed 2016-10-27.

Thread 11 (2016-10-30):

Validated Rev C Gerbers #2

kb1lqc, 2016-10-30:
Check Rev C Gerbers against Rev B Gerbers to make sure any and all differences are accounted for. The quickest way to do this is to use GerbV to XOR Rev B and Rev C, leaving the differences highlighted.

I needed to change the gerbers to account for Advanced Circuits stackup which changed the 50 Ohm and 100 Ohm traces as well as forced the pullback of some copper ground planes. I also noticed that I had to change a few via's back to 13 mil holes but that didn't show up on the last attempt. Wierd.
- [x] Faraday.drl
- [x] Faraday-B_Cu.gbl
- [x] Faraday-B_Mask.gbs
- [x] Faraday-B_Paste.gbp
- [x] Faraday-B_SilkS.gbo
- [x] Faraday-drl_map.pho
- [x] Faraday-Dwgs_User.gbr
- [x] Faraday-Eco1_User.gbr
- [x] Faraday-Eco2_User.gbr
- [x] Faraday-Edge_Cuts.gbr
- [x] Faraday-F_Cu.gtl
- [x] Faraday-F_Mask.gts
- [x] Faraday-F_Paste.gtp
- [x] Faraday-F_SilkS.gto
- [x] Faraday-InnerA_Cu.gbr
- [x] Faraday-InnerB_cu.gbr
- [x] Faraday-NPTH.drl
- [x] Faraday-NPTH-drl_map.pho

kb1lqc, 2016-10-30:
# Faraday.drl

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

* Changes are exactly where I'd expect them to be
* Fixed some wierd holes like vias for the ADC RC filters that had gone to 10 mil drills from 13 but weren't on the last gerber attempt...

kb1lqc, 2016-10-30:
# Faraday-B_Cu.gbl

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
* Only GD0 and RF control routing changed on bottom layer as expected
* Rev B changed to Rev C on outside of board edge markings

kb1lqc, 2016-10-30:
# Faraday-B_Mask.gbs

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

* No changes to bottom layer soldermask as expected from Rev B to Rev C

kb1lqc, 2016-10-30:
# Faraday-B_Paste.gbp

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

* No change to bottom solder paste layer as expected

kb1lqc, 2016-10-30:
# Faraday-B_SilkS.gbo
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

* Faraday and Rev B markings removed from bottom silkscreen layer

kb1lqc, 2016-10-30:
# Faraday-drl_map.pho
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
* Drill map shows only changes in GD0 and RF control area.
* not shown on here is the drill map hole count showing two less 13 mil via's on Rev C, I removed two from the RF SMA connector to keep the ground away from RF microstrip traces.

kb1lqc, 2016-10-30:
# Faraday-Dwgs_User.gbr
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

* Only changes on drawings layer are stackup notes for Advanced Circuits stackup changes from previous OSHPark stackup.

kb1lqc, 2016-10-30:
# Faraday-Eco1_User.gbr

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
* R7 in power supply area was removed as expected
* Rev B to Rev C marking outside of board area also updated as expected
* ADC lines moved to be a more organized layout
* 100 Ohm and 50 Ohm traces on top layer from CC430 changed due to Advanced Circuits 4 layer PCB stackup
* Ground copper pulled away from top layer pour near 50 Ohm RF transmission lines
* GPIO traces moved along with RF control traces for GD0 update as expected

kb1lqc, 2016-10-30:
# Faraday-F_Mask.gts
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
* R7 in power supply area changed as expected
* L10 and nearby component moved so the soldermask moded too

kb1lqc, 2016-10-30:
# Faraday-F_Paste.gtp
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
* Same as soldermask, solderpast changed only for R7 in the power supply section and the RF L10 section

kb1lqc, 2016-10-30:
# Faraday-F_SilkS.gto
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
* R7 and L10 area's changed as expected for changed component placement
* Old Faraday logo removed
* New Faraday logo + OSHW logo added
* TAPR OHL text added
* Faraday and Rev C text added

kb1lqc, 2016-10-30:
# Faraday-InnerA_Cu.gbr
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
* Only changes on this layer, which is a solid groundplane, are those required with moved via's in the area of GPIO and RF control traces moved for GD0 modifications.
* Removed ground via's at SMA connector don't show up here since ground via's don't have groundplane layer pullback.
* Rev B text updated to Rev C outside of board edge area.

kb1lqc, 2016-10-30:
# Faraday-InnerB_cu.gbr
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
* Rev B text outside of board area changed to Rev C
* 50 Ohm trace changed size for Advanced Circuit stackup, ground pour pulled away too.
* Via's for control traces of GPIO and RF CC1190 moved as needed for GD0 update

kb1lqc, 2016-10-30:
# Faraday-NPTH.drl
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
* No changes to non-plated through holes as expected

kb1lqc, 2016-10-30:
# Faraday-NPTH-drl_map.pho
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
* As expected no changes to the non-plated through-hole layer means no changes to the map either!

kb1lqc, 2016-10-30:
# Faraday-Eco1_User.gbr
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

* Eco Layer 1 shows rough component courtyards and as expected R7 was removed and the components areound L10 also moved due to 0603 footprint change.

kb1lqc, 2016-10-30:
# Faraday-Eco2_User.gbr
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
* Eco Layer 2 is used for external tab routing drawings, no changes as expected

kb1lqc, 2016-10-30:
# Faraday-Edge_Cuts.gbr
* Not worth putting image here as there's literally nothing to show, no changes to the board shape or size from Rev B to Rev C

kb1lqc, 2016-11-02:
Files checked out OK.

Closed 2016-11-02.

Thread 13 (2016-11-02):

Kicad_pcb file breaks Macrofab Parser

kb1lqc, 2016-11-02:
When trying to upload the kicad_pcb file directly to macrofab to get quotes, the parser would fail. Thanks to their help it was identified as a single quote around line 7,288 in

Commit: https://github.com/FaradayRF/FaradayRF-Hardware/commit/0bd3c28bf71e9eca5ecc376e44965096ef62eabf

Error
```
(gr_text "0.063\" +- 10%" (at 294.64 127.762) (layer Dwgs.User)
    (effects (font (size 1.5 1.5) (thickness 0.3)))
```
This text is on my drawings layer for the PCB stackup. It appears that the escape used for the quote isn't dealt with nicely in the parser.
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

kb1lqc, 2016-11-02:
OK, Macrofab now uploads successfully withou the quote. Complete.

Closed 2016-11-02.

Thread 14 (2016-11-02):

Test GPS Without Ferrite Inductors and Capacitors

kb1lqc, 2016-11-02:
The GPS is a prime spot to remove components from. We may not actually need the 900MHz RF protection ferrites and capacitors.

**Inductors**
- [x] L23
- [x] L6
- [x] L20
- [x] L21
- [x] L22

**Capacitors**
- [x] C24
- [x] C55
- [x] C68
- [x] C69
- [x] C70

**Testing in Hardware on Rev B**
- [x] Tested

Basic testing of removing these parts or shorting around them and verifying that when transmitting the GPS remains locked is a good real-world test.

kb1lqc, 2016-11-03:
Tested at full power (152 in Balloon Flight Software/Firmware) without capacitors but with all inductors and GPS lock was achieved. 1Hz telemetry transmission interval over RF was the fastest I could have it do with this firmware.

kb1lqc, 2016-11-03:
GPS lock achieved with inductors and capacitors removed! Tried removing antenna to cause reflections which didn't affect the GPS lock (quality = 2) either. Placed my hand on the RF section to increase parasitics as well as handled the GPIO circuitry to try to mess it up with skin conduction but it remained locked.

Was transmitting at full power (152) with the HAB flight software/firmware. The only think I didn't try was bring a second Faraday super close to this Faraday. Since they all operate on similar frequencies this seems unlikely to cause an issue.

kb1lqc, 2016-11-10:
Moved to RevD branch. Removed the following:

**Inductors**
- [ ]  L23
- [ ]  L6
- [ ]  L20
- [ ]  L21
- [ ]  L22

**Capacitors**
- [ ]  C24
- [ ]  C55
- [ ]  C68
- [ ]  C69
- [ ]  C70

Closed 2016-11-03.

Thread 15 (2016-11-02):

Remove GPS Lock LED

kb1lqc, 2016-11-02:
We actually don't need this. Additionaly, we could hook it back up to an interrupt driven IO pin and flash the main LED or at least indicated in telemetry with or without the Fixed indicator pin.

- [x] R23
- [x] D8

kb1lqc, 2016-11-02:
Decided to DNP R23 and D8

kb1lqc, 2016-11-03:
I shouldn't have to test this. It's pretty self-evident and there should be zero issues from DNPing these parts simply by design.

kb1lqc, 2016-11-10:
Rev D Branch will have these removed. They are simply not necessary. We can detect a GPS lock with the CC430 UART and blink an LED we already have if necessary.

kb1lqc, 2016-11-10:
Removing:
- [x] D8
- [x] R23

Closed 2016-11-10.

Thread 16 (2016-11-02):

Remove GPS RF Capacitor C66

kb1lqc, 2016-11-02:
Since it appears we don't actually need to tune this antenna why not simply directly connect copper between pins 4 and 6 of the M104780A2 GPS? Remove inductors for tuning while I'm at it.

- [x] C66
- [x] L18
- [x] L19
- [x] Tested

kb1lqc, 2016-11-03:
Tested with C66 bypassed using wire (definitely conservative at 1.5GHz...

L18 and L19 DNP already so this is promising. Closing.

kb1lqc, 2016-11-10:
Used clean Master branch to create RevD branch which starts fresh.

Removed

- [x] C66
- [x] L18
- [x] L19

Closed 2016-11-10.

Thread 19 (2016-11-02):

Remove or Make ADC Filters Easily Solderable

kb1lqc, 2016-11-02:
The ADC filters are quite a few parts that we should either move to easily solderable components or remove them. This is a tricky one...

- [ ] R24
- [ ] C47
- [ ] R25
- [ ] C48
- [ ] R26
- [ ] C49
- [ ] R27
- [ ] C50
- [ ] R28
- [ ] C51
- [ ] R29
- [ ] C52
- [ ] R30
- [ ] C53

kb1lqc, 2016-11-03:
I removed R25 and C48 of ADC5, bridging over R25 to short across the contact effectively directly tapping into the ADC pin. I then took a piece of 6 inch wire and stuck it into ADC4 which still had the Low Pss RC filter to plot this 2 minute long graph of the wire allowing noise into the ADC4 channel.

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

Looking at ADC5 which has no Low Pass Filter, a six inch wire plugged into it conducted noise into the ADC5 pin which is clearly evident without a filter.

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

Testing performed with HAB flight firmware/software.

kb1lqc, 2016-11-03:
Oh boy, actually it makes sense to make ADC2 the microphone ADC input since it's also the external positive voltage reference pin.

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

I'll create an issue to update this pin in the design.

kb1lqc, 2016-11-10:
I adressed the move to ADC2 with the microphone/Vref input in #23. This is present on the RevD branch. Otherwise **I'm choosing to leave the ADC filters on all other channels.**

Closed 2016-11-10.

Thread 20 (2016-11-02):

Remove AVCC RC Filter And Low Frequency Crystal

kb1lqc, 2016-11-02:
The ADC AVCC filter isn't really needed, just keep the decoupling capacitor. We never really use the low frequency watch crystal X1 (32.768 KHz). Should DNP that.

- [x] R17
- [x] C7
- [x] C8

**Testing**
- [x] Testing

kb1lqc, 2016-11-02:
R17 removed

kb1lqc, 2016-11-03:
Tested Faraday with HAB Flight software/Firmware with R17 removed/shorted, worked fine as expected. Leaving C7 decoupling capacitor on.

kb1lqc, 2016-11-03:
Removed C7 and C8 without what appears to be any affect. Hard to measure frequency with an oscilloscope probe as it appears to be pretty low amplitude and the probe will likely be affecting the signal anyways. Would be best to use a counter internal to the CC430 to check this frequency but @kb1lqd says there are internal capacitors that can help mitigate issues we see. I'll DNP instead of removing anyways.

To test this we could just count the cycles based on X1 and divide by 32768, then trigger an IO pin. If we are anywere near 1Hz edges then this is pretty spot on.

kb1lqc, 2016-11-10:
Moved to RevD, DNPd:

- [ ] C7
- [ ] C8

kb1lqc, 2016-11-10:
Also removed AVCC filter resistor:

- [ ] R17

Closed 2016-11-10.

Thread 21 (2016-11-02):

Remove Button and LED 2

kb1lqc, 2016-11-02:
The button has rarely seen actual use and the second LED is nice but maybe we could DNP it or remove it entirely.

- [x] BTN1
- [x] R2
- [x] D2

Haha... R2 and D2 are the LED 2 components... oh it's the small things 😆

kb1lqc, 2016-11-02:
R2 and D2 have been DNP'd

kb1lqc, 2016-11-02:
Decided to just DNP the button and leave it connected to the CC430.

kb1lqc, 2016-11-03:
I don't believe I need to test this. It's pretty self-evident what will happen and there should be zero issues resulting from DNPing these parts.

kb1lqc, 2016-11-10:
Decided to leave these on. It's cheaper than expected to leave these on and they are useful in the end. Not necessary, but useful. RevD branch will have them.

kb1lqc, 2016-11-30:
Button was removed in the end as a DNP.

Closed 2016-11-10.

Thread 22 (2016-11-02):

Simplify Power Supply

kb1lqc, 2016-11-02:
We decided that while the power supply of Rev C is awesome! This is a board that will be produced in large quantities and we don't need this much complexity.

* Use diodes to combine USB and external power
* Remove LC filter, consider keeping bulk capacitance and damping resistor
* Remove soft-start circuitry
* Remove 3.3V second LPF that's probably not needed.

kb1lqc, 2016-11-04:
OK I've spent a rediculous amount of time thinking about this tonight. I don't have a good way to test USB inrush current and while on my previous USB testing in #5 I was OK with this since I knew I had a soft start circuit, now I am talking about removing the soft start circuitry which therefore makes me nervous.

## Should I Be Nervous?
Probably not. Most people seem to be OK with putting well over 10uF on the USB bus. However, I would really prefer that Faraday doesn't have issues like causing a USB hub to reset during insertion. This would make me feel much better to know I simply don't need to worry about it.

## Why Do I Need > 10uF on VBUS?
The TPS562201DDCR needs a minimum capacitance and in order to gauruntee the correct operation of the switcher over the 17V input range of Faraday I need to account for voltage bias loss with the capacitors. This puts over 20uF on to the bus, closer to 30uF.

## Concluding Thoughts
In the end I'm trying to reduce BOM line items and part count. However, the MIC94072YC6 is about $0.30 each and doesn't even need input/output bypass capacitors. For the cost of one line item and one assembly placement I get assurance that the 1uF minimum load is sufficient upon initial USB power application but not too much. I still get to remove a ton of power supply parts and I'd like to remove one of the 10uF capacitors, C54, leaving C17 and R8 as bulk capacitance. This seems like a happy medium for all. However, if I don't use the 2 Ohm resistor elsewhere maybe I should just forget about it.

## Final Thought on Testing
Why not just test with and without the MIC94072YC6 and look at the voltage drop at the USB hub/port when I insert Faraday onto the bus. Per USB compliance documents the real test is whether USB voltage drops more than 330mV.

kb1lqc, 2016-11-05:
OK I removed several parts and tested Faraday to make sure it still works well.

* Q3
* Q4
* L1
* C54
* U2
* C15
* U11
* C58
* L17

I also bypassed U12 and used diodes to OR together VCC and 5V USB.

AC Coupled:
5V USB Bus: Quickprint 41
C41 Voltage: Quickprint 42
3.3Vout : Quickprint 43

DC Coupled:
3.3Vout: Quickprint 44

kb1lqc, 2016-11-05:
I measure 4.76V on the input of the TPS regulator with this setup.  It's worth nothing the diodes I am using are CRS01QCT-ND devices. Given a 230mV p-p voltage drop (worst case assuming no ringing positive which actually happened) this means that I can expect about 4.76V-0.23 = 4.53V on the input of the TPS regulator which is still 1.2V above the 3.3V output voltage.

The TPS562201DDCR is rated to operate from 4.5V which is close but we seem to be compliant.

kb1lqc, 2016-11-10:
On the RevD Branch I performed the following:

Removed:

- [x] U12
- [x] U11
- [x] C15
- [x] U2
- [x] R13
- [x] Q4
- [x] Q3
- [x] L1
- [x] C17
- [x] R8
- [x] L17
- [x] C58

The following was added:

- [x] D3
- [x] D4

kb1lqc, 2016-11-30:
Ended up moving back to the Ideal diode due to voltage drop across the diodes and tolerance on the USB voltage.

Closed 2016-11-10.

Thread 23 (2016-11-03):

Move Microphone/Unfiltered input to ADC2 P2.5

kb1lqc, 2016-11-03:
This pin is also the external VREF+ input so we dual purpose it.

kb1lqc, 2016-11-10:
Removed:
- [ ] R28

DNP'd:
- [ ] C51

kb1lqc, 2016-11-10:
Added filter back in for:
- [x] R25
- [x] C48

Closed 2016-11-10.

Thread 25 (2016-11-13):

Test USB Bootloader FTDI Functionality

kb1lqd, 2016-11-13:
Verify that REV C boards which contain the FTDI traces as tested with flywire correctly load bootloader of TI and program board.

kb1lqd, 2016-11-16:
I ran the as last saved (with COM port updated) BSL uploader I wrote and it worked almost:

- FTDI connects and toggles GPIO's for BSL entry mode
- BSL entry mode works! That's the hard part and the one hardware dependent.
- For some reason the file always fails checksum in the end... I tried both 115200 and 9600 baud..

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

I'm using the unit that I just took off the external 18pF LFXTAL1 load capacitors (REV B1 SN#3) but that shouldn't affect this. It should use the REFOSC...

kb1lqd, 2016-11-16:
I tried quickly again with the other REV B1 on COM 3 and the unit is still slow:

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

kb1lqd, 2016-11-16:
I loaded an old code on with the BSL to REV B1 and to my inspection it looks correct. I can play with LED's to absolutely verify but I feel confident due to the above debugging and known good scripts verifying the matching checksum's.

Closing.

Closed 2016-11-16.

Thread 26 (2016-11-13):

Test LFXTAL1 With Internal Capacitors

kb1lqd, 2016-11-13:
Test the CC430's ability to operate with these capacitors DNP'd.

kb1lqd, 2016-11-16:
# Faraday Unit Setup
**SN:** 3

I removed C7 and C8 capacitors from REV B1 that capacitively load the low frequency crystal X1. These are 18pF capacitors that should be able to be supplied by internal capacitors from the CC430.

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

## Initial Boot with NO capacitors

Looks like it's booting and giving UART data! The frequency is likely offset a bit. Even 18pF was a conservative estimate.
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

kb1lqd, 2016-11-16:
I updated the firmware master in commit (13833d0b36bc32281c88fcfc904557dc15d56363) that includes the updated internal capacitance 12pF crystal load. Make sure to remove the capacitors from the other boards we currently have!

Also, I committed to master. SORRY!

Closed 2016-11-16.

Thread 27 (2016-11-13):

Test GPS without inductors using increase data throughput

kb1lqd, 2016-11-13:
Re-test #14 with code that sends lots of RF data to verify.

kb1lqd, 2016-11-16:
@kb1lqc I assume to test this I can just remove and short over all the removed inductors like you did?

I plan on testing several more in-depth configurations:
- Basic firmware update to force constant RF TX buffer data to push unit as-is as fast as it can go indefinitely. I will first look for the GPS lock to remain after several minutes. I can also verify GPS data, not sure if I'll get telemetry during TX while jerry-rigging this.
- Initiate a constant output IDLE or carrier and check the GPS lock LED / data remains as well

kb1lqc, 2016-11-17:
@kb1lqd Yes you could just short over them. Probably should remove the caps though too.If you want I can give you my Faraday unit with these modifications Thursday. If you create this mode then it's simple to just wait a day and test it Thursday evening.

kb1lqd, 2016-11-17:
# Continuous TX Program

I made a really basic continuous transmit program using the standard Faraday RF stack after messing around with the continuous TX methods of the CC430 hardware settings and failing. This basic branch directly fills the RF layer 2 FIFO every housekeeping cycle with a new packet (blank/random data) and thus due to it's speed the FIFO should be full nearly always. This may not be fully continuous but is very very close. The button on the PCBA toggles a bit that enters this mode and allows continuous transmission THIS IS A TEST MODE AND SHOULD NEVER BE PULLED INTO MASTER!

I set the unit to 914.5MHz and an RF power setting of 152 which corresponds to about 500mW. Letting this unit transmit continuously should allow us to see if any power quality issues are observered or if the GPS with and without RF LC filters is affected by the transmissions.

kb1lqd, 2016-11-18:
# Test-2 - SN1 In REV D1 Configuration

I ran the transmissions for a few minutes at full power with the GPS locked and running proxy to debug observe the effects of REV D1 configuration and full power GSM at 914.5MHz. I attached a ~6 inch 9V battery harness and battery and reran the test and the GPS lock light remained flashing indicating good lock again.

I reran the test at 927.5MHz and passed with both USB and battery power.

I reran the test at 902.5MHz and passed with both USB and battery power.

I'm considering this testing issue resolved!

Closed 2016-11-18.

Thread 29 (2016-11-15):

PCB Text Verification

kb1lqc, 2016-11-15:
Verify text on PCB is correct

- [ ] Silkscreen logos
- [x] Silkscreen Text Top
- [x] Silkscreen Text Bottom
- [x] Reference Designators

kb1lqc, 2016-11-16:
## Silkscreen Top/Bottom
 * Removed MOSFET text near Q1
 * Removed GPS Fix text
 * Moved GPS Receiver text
 * Added button text on bottom

kb1lqc, 2016-11-16:
## FaradaRF Logo
 * About 325 mil wide by 195 mil tall
 * Looks good to me!
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

## OSHW Logo
 * About 340 mil wide by 355 mil tall
 * Again looks good! Used Dave Jones (EEVBlog) idea for logo cog letters
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

## TAPR OHL V1.0
 * Simple PCB Text marking the hardware license used
 * 310 mil wide by 50 mil tall
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

## Faraday Name and Revision
 * Revision D1 refers to consolidated production model (Rev C was never built). The numeric 1 stand for the first minor revision of Rev D which is optimized for PCB:NG stackup
 * About 340 mil wide by 120 mil tall
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

kb1lqc, 2016-11-16:
Added External Reference/Microphone text to bottom of PCB for ADC2 to help identify it.

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

kb1lqc, 2016-11-16:
OK calling it done. Spent enough time here. Looks good!

Closed 2016-11-16.

Thread 30 (2016-11-15):

Power Supply Routing

kb1lqc, 2016-11-15:
Verify power supply layout is optimal
- [x] Matches reference design closely
- [x] VCC routed correctly from connector
- [x] USB power routed correctly from connector
- [x] 3.3V net routing

kb1lqc, 2016-11-15:
## Suggested Layout
[tps562201 Datasheet](http://www.ti.com/lit/ds/symlink/tps562201.pdf)

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

kb1lqc, 2016-11-15:
## Di/dt and Dv/dt Power Path
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
Seems to be good! Pretty concise and tight while adhering to the reference design.

kb1lqc, 2016-11-15:
## Grounding Between Layers

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

Overall looks good!

kb1lqc, 2016-11-15:
## 3.3V Power Distribution
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

* 3.3V Inner B routing seems to be concise and OK

kb1lqc, 2016-11-15:
## USB Power Routing
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

* Red line is 5V USB power path to 3.3V regulator input
* Power path seems OK and always has a ground under it. Not very easy to optimize this as it's going to an odd part of the board but overall this will be DC with a little noise on it so it should be OK. Not like this is a switching node.

Closed 2016-11-15.

Thread 31 (2016-11-15):

RF Trace Impedance for PCB:NG

kb1lqc, 2016-11-15:
Referring to [PCB:NG](http://pcb.ng/index.html)'s stackup to create 50 Ohm traces for long runs of RF
- [x] Top Layer
- [x] Inner B Layer

kb1lqc, 2016-11-16:
## Updated RF Routing for Better Isolation
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
 * Red pen Lines show copper pullback for ground pours on same layer as RF routing
 * Green pen lines show via fences which also pulled back.

I decided to update the RF routing to get at least 3x the PCB ground reference height from the RF trace to the nearest ground pour on the same layer. While I couldn't hold this everywhere, it's nearly all correct.

PCB:NG uses  a 13 mil spacing between the Top Layer and Inner A as well as the same spacing between the Bottom layer and Inner B. The core is 28 mils between Inner A and B. Therefore I should have about 3x13mils = 39mils of copper pullback. I went for 4x and kept about 50 mils to be safe.

Via fences were moved to accomodate as well as clean up their placement. I also moved the ground traces from the SAW filter which were redundant and above the SAW filter to help align the via fence above the CC1190 PA area.

kb1lqc, 2016-11-16:
## Pulled Back Ground More Near LNA
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
 * I pulled the ground away in the area inside the red pen circle to help protect the LNA.
 * The goal was to achieve 50 mils but in some areas I was forced to leave the ground only 7 mils away. However these areas are unavoidable without drastic redesign and frankly not worth it 😄

kb1lqc, 2016-11-16:
## Inner Layer Impedance
Using Saturn PCB Toolkit I've calculated the necessary trace with of 16.7mils to achieve 50 Ohms on Inner B (Blue) layer.

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

- [x] Inner B layer shows correct 16.7 mil trace width on CC1190 RF section

kb1lqc, 2016-11-16:
## Top Layer 50 Ohm Trace
Again using Saturn PCB and the PCB:NG stackup I've calculated a nominal 25.6mil trace width for the top or bottom layers (since they are both microstrips with same properties).
 * Top or bottom layers hard reference Inner A and Inner B layers respectively
 * About 50 mils spacing for ground pour on same layere wherever possible

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
 * CC1190 RF section looks good

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
 * The GPS has a small section with RF traces exiting and immediately reentering the module where I also pulled back the ground pour
 * I know it looks a bit wonky but I kept the ground behind the RF pin because the two pads for ground are immediately adjacent to the RF pin 6 so it doesn't really make a difference.
 * Achieved 50mil pullback for most of the area.

Closed 2016-11-16.

Thread 32 (2016-11-15):

Fiducial & Mousebite Locations

kb1lqc, 2016-11-15:
Check that locations are correct and make sense. PCB:NG may not need mousebites predefined but it helps them even if they don't use my exact design.
- [x] Mousebite locations
- [x] Fiducial locations

kb1lqc, 2016-11-16:
## Fiducials
FD2 on top layer bottom left is the origin of all parts on the board. Its XY coordinate is 0,0!
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

FD1 on Top Layer and FD6 on Bottom layer are offset from each other. This allows you to know absolutely if you are measuring fiducials on the top layer or on the bottom layer.
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

Mousebites are clearly on all four sides of the PCB. The copper pours and all traces are pulled back out of the danger area near the tabs were cutting through the NPTH's can cause traces to crack. These mousebites are circled in red.

The fiducials are circled in orange and are on the bottom left, bottom right, and top right corners of the top layer. Fiducials on the bottom are located on the bottom left, bottom right  and top left corners of the PCB.

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

kb1lqc, 2016-11-16:
The ECO2 layer of the Faraday PCB design clearly documents the intended path of a 100 mil routing bit to cut out each PCB from a panel.

Closed 2016-11-16.

Thread 33 (2016-11-15):

Rev C to Rev D Gerber Changes

kb1lqc, 2016-11-15:
Rev C Gerbers have been checked thoroughly against the Rev B design in #11. Now, I need to make sure changes going to Rev D also make sense.

- [x]  Faraday.drl
- [x]  Faraday-B_Cu.gbl
- [x]  Faraday-B_Mask.gbs
- [x]  Faraday-B_Paste.gbp
- [x]  Faraday-B_SilkS.gbo
- [x]  Faraday-drl_map.pho
- [x]  Faraday-Dwgs_User.gbr
- [x]  Faraday-Eco1_User.gbr
- [x]  Faraday-Eco2_User.gbr
- [x]  Faraday-Edge_Cuts.gbr
- [x]  Faraday-F_Cu.gtl
- [x]  Faraday-F_Mask.gts
- [x]  Faraday-F_Paste.gtp
- [x]  Faraday-F_SilkS.gto
- [x]  Faraday-InnerA_Cu.gbr
- [x]  Faraday-InnerB_cu.gbr
- [x]  Faraday-NPTH.drl
- [x]  Faraday-NPTH-drl_map.pho

kb1lqc, 2016-11-17:
## Top layer
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
 * All changes seem to make sense.
 * This is the most complex layer to check. Should be downhill from here...
 * Poked around in Rev D only and it looks good.
- [ ] Compare with silkscreen and soldermask layers too!

kb1lqc, 2016-11-17:
## Inner-A Layer
 * Dedicated to ground except for outside edges where areas are CGND trace for mounting holes
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

 * All changes seem to make sense, no complaints

kb1lqc, 2016-11-17:
## Inner-B Layer
 * Used largely for 3.3V power distribution but also RF routing and ground pour
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
 * All changes seem to be in areas I'd expect them to be

kb1lqc, 2016-11-17:
## Bottom Layer
 * Largely a groundplane and signal layer
 * Used as reference for RF traces on Inner-B

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
 * Changes seem to make sense

kb1lqc, 2016-11-17:
## Front Silkscreen
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
* All changes seem expected!

kb1lqc, 2016-11-17:
## Bottom Silkscreen
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
 * All changes as expected
- [ ] In retrospect do I want to add teh GPS fix text to the bottom test point?

kb1lqc, 2016-11-17:
## Bottom Soldermask
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
* Looks fine, only change was 3.3V test point moving as expected

kb1lqc, 2016-11-17:
## Top Soldermask
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
* As expected changes are where they should be, GPS section, Power section, RC filters for ADC, CC40 AVCC input, and a small move in the RF section for an inductor

kb1lqc, 2016-11-17:
## Top Solderpaste
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
* Everything as expected, Power supply, GPS, CC430 AVCC, ADC2 RC filter, and RF section inductor move

kb1lqc, 2016-11-17:
## Bottom Solderpaste
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
* Literally no changes as completely expected 😆

kb1lqc, 2016-11-17:
## Engineering Layers
In the interest of saving time and unecessary images I'll review a few layes with just text.

### Eco 1
* This layer outlines where components are on the PCB, basically it's the ir JEDEC normal courtyard.
* All changes as expected, GPS, Power Supply, RF section, and CC430/ADC area.

### Eco 2
* This layer outlines the routing bit center path for a 100 mil tab routing outline during panelization
* No changes as expected

### Drawing Layer
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
* Stackup notes changed as expected
- [ ] ⚠️ Add "ROUTING HERE" back in!

### Plated Through Hole Drill Map
* As expected lots of changes but they are in areas as expected and only 13 mil (standard) holes saw a count change which is expected because I only route with 13 mil vias on Faraday.

### Plated Through Hold Drill
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
* Lots of changes as expected. Everything appears to make sense though checking each hole would be obnoxious.

### Non-Plated Through Hole Drill Map
* No changes as expected

### Non-Plated Through Hole Drill
* As expected, no changes

kb1lqc, 2016-11-17:
### PCB Edge Cuts
* No changes, as expected

kb1lqc, 2016-11-17:
⚠️ Changes from this Review:
 * Added in missing "ROUTING HERE" text on drawing layer
 * Adjusted all "ROUTING HERE" text on drawing layer to line up better
 * Added "GPS FIX" Text to test point on bottom silkscreen
 * Added a single new via for ground near GPS to fill in bottom layer copper pour

kb1lqc, 2016-11-17:
Whoa found that C42 was missing a ground via next to it! Added. Will be in next commit

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

kb1lqc, 2016-11-21:
Closing this ticket. Reviewed board gerbers with @kb1lqd and we found a few small cosmetic issues but nothing bad. Changes were made. Overall the gerbers are now VERY different from these reviewed gerbers on this ticket. However they are mostly in known way such as soldermask pullback and silkscreen modifications. Closing.

Closed 2016-11-21.

Thread 34 (2016-11-15):

Update Rev D BOM

kb1lqc, 2016-11-15:
Create a known-good Rev D BOM

kb1lqc, 2016-11-21:
Created in https://github.com/FaradayRF/FaradayRF-Hardware/pull/41/commits/f2f15c6f3cfcc669f786e9bba21574d92cefe05a which represents the PCB as built and delivered in full use state. The boards will be assembled without GPS or through-hole parts. They will then be offered with GPS on one of two boards and the through-hole parts soldered on.

Closed 2016-11-21.

Thread 35 (2016-11-15):

Create Rev D1 pick and Place Files

kb1lqc, 2016-11-15:
Create new pick and place files for Rev D1 specialized for PCB:NG's needs.

kb1lqc, 2016-11-19:
Added Fiducials which I realized were missing! cb88a0e8ccfb084bbe348435397033d314ff4594

kb1lqc, 2016-11-20:
Hmm I noticed U9 was in my output file uploaded to PCB:NG. check latest pos file against XLSX and CSV files, including quick check of xy data too.

- [ ] checked

kb1lqc, 2016-11-21:
Checked and updated in https://github.com/FaradayRF/FaradayRF-Hardware/pull/41/commits/f2f15c6f3cfcc669f786e9bba21574d92cefe05a Let's do this! File has been optimized for.

Closed 2016-11-21.

Thread 36 (2016-11-16):

Combine Drill Files for PCB:NG

kb1lqc, 2016-11-16:
Title says it all. PCB:NG determines plating with presence of copper in hole.

kb1lqc, 2016-11-19:
Not necessary anymore, as of cb88a0e8ccfb084bbe348435397033d314ff4594 there are no mousebites and therefore no NPTH's. Closing.

Closed 2016-11-19.

Thread 37 (2016-11-17):

Rev D1 Gerber Review

kb1lqc, 2016-11-17:
Simply Looking at the board to see if everything makes sense. Very 10k foot view stuff.

kb1lqc, 2016-11-18:
# Top Layer With Soldermask & Solder Paste

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
 * Overall looks good nothing seems extremely off or erroneous
 * It's obvious that the 4 mil soldermask clearance causes may of the SOT, QFN, and USB type parts to simply not put soldermask in a big block around the pins as they are so close.

**The CC1190 RGV Footprint**
Working with PCB:NG it became apparent that the soldermask slivers needed to be dealt with. The problem was that the corners of the corner pads were < 4 mils from each other. This prompted me to place four rectangles 4milx10mil of soldermask only at 45 degree angles between these pads to force the slivers to be removed. Below this soldermask layer is green.
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

**CC430 RGC Footprint**
Similar to the CC1190, the 4 mil clearance of soldermask caused the pins to largely be blocked out. Naturally the corners formed areas where the soldermask areas were flowing into each other.
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

kb1lqc, 2016-11-18:
## Top Layer Vs Inner A Layer
* Inner A layer provides ground plane for the entire board and it appears to be almost everywhere sans vias on a different net and the outer CGND route.

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

kb1lqc, 2016-11-18:
## Inner A and Inner B Layers
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
 * Inner A provides groundplane while Inner B provides power and RF routing, however Inner B is closer to the bottom (13 mil) than Inner A (28 mil) so it's a weaker reference.
 * The RF route on Inner B appears to be completely covered with a ground plane on Inner A except where via clearance is necessary and that's expected.
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
 * ⚠️ 3.3V routing on Inner B seems a bit constrained but as shown with green markings below there appears to be a decent amount of copper passing through, certainly a lot for ~700mA.
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

kb1lqc, 2016-11-18:
## Inner B to Bottom Layer
* Inner B largely routes power around the PCB but also RF.
* Lines running on bottom layer don't need ground on Inner B since Inner A provides the ground reference. However this is not the case for impedance sensitive RF lines!
* RF traces on Inner B only 13 mils away from  bottom layer so tightly coupled and must be ground!
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

RF traces look good.
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

kb1lqc, 2016-11-18:
## Bottom Layer with Soldermask and Solderpaste
* Looks good!
* Test points appear to be free of soldermask
* JTAG connector looks good
* Mounting and through hole connectors look good too

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

kb1lqc, 2016-11-18:
## Component Courtyards and Front Silkscreen
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
* OSHW logo could move a little to the right ❔
* Otherwise looks great, no overlapping component courtyards or reference designators

kb1lqc, 2016-11-18:
## Component Courtyards and Bottom Silkscreen
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
* I forgot to mention the ECO1 layer which has courtyards on it has both top and bottom courtyards so one must mentally distinguish from components on the top and bottom.

- [ ] 3.3V test point text is far away from test point ⚠️
- [ ] JTAG pad text is not lined up well ⚠️
- [ ] Add a note about voltages > 3.3V on ext mic/ref pin can damage Faraday! ⚠️

kb1lqc, 2016-11-21:
Sat down with @kb1lqd and reviewed Gerbers with him. We found a few items that I changed which were non-critical but worth changing now:

- [x] GPS Antenna Silkscreen on top/bottom updating
- [x] VCC and GND Silkscreen on top for power header row marking better
- [x] CC1190 pin 1 and 16 still had manual soldermask pullback settings

Fixed in the latest commit with new gerbers and and updated pick and place files with the BOM:
https://github.com/FaradayRF/FaradayRF-Hardware/pull/41/commits/f2f15c6f3cfcc669f786e9bba21574d92cefe05a

Closed 2016-11-21.

Thread 38 (2016-11-17):

PCB:NG DFM Errors

kb1lqc, 2016-11-17:
Working through their DFM errors to make an extremely easy to manufacture board
 * Wow, this seems really nice. I like what [PCB:NG ](www.pcb.ng) has done!
 * Using the new [RAND beta software](https://blog.pcb.ng/the-mask-of-the-red-yeoman/)

- [x] Reduce errors
- [x] Move reference designators back after updating modules

kb1lqc, 2016-11-17:
* Moved ground via on pin 1 of Antennoa GPS U7 away from board edge ✔️
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

### Minimum trace width on Top Layer
  * Not sure what these mean, I can't really see where the traces are less than 4 mil... Is the DFM check confusing the pad overlayed with the trace to be another trace... basically the part of the C9 pad that's handing off to the right of the arrow?
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

 * Another instance of the same problem near the FT230X USB UART... I can't see what's wrong...
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

### Minimum Trace Space on Outer Layers
* Looks like a ground via is a bit too close but not connected to the ground pour. Kicad won't catch this 😄
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
I added some copper pour zones to pour into the vias. Doesn't really make a difference for RF microstrip copper pullback since the via is already there.

### Soldermask Slivers
* Whoa there are hundreds of these... looks like every 0402 part at a minimu.
* I changed the Kicad global setting for a minimum soldermask of 4 mils. Let's see what that buys us on new gerbers.
- [ ] Check soldermask swell again ⚠️

### Minimum Mask to Copper Clearance
* This looks to be like a minimum soldermask clearance setting. I'll change my global values to 4 mils
- [ ] Check soldermask clearance again ⚠️

kb1lqc, 2016-11-19:
Updated gerbers to 4 mil clearance and checked with PCB:NG DFM tools. Also, PCB:NG has confirmed that with a third party DFM tool they see no errors either.

commit: cb88a0e8ccfb084bbe348435397033d314ff4594

Closed 2016-11-19.

Thread 39 (2016-11-19):

Remove Mousebites for PCB:NG

kb1lqc, 2016-11-19:
Unecessary mousebites with PCB:NG because they automatically place their own for tab routing on a panel. They will use the spots for their own mousebites once I remove them. Following this, I won't need to combine the drill files either since all holes will be plated.

kb1lqc, 2016-11-19:
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

Mousebites removed! Only sections of copper where they were pulled back on each side remain which will be useful for manufacturing.

Closed 2016-11-19.

Thread 40 (2016-11-19):

PCB:NG Removed BOM Items Must Be Populated

kb1lqc, 2016-11-19:
To enable work on PCB:NG placement I need to remove a few parts from the BOM on their website to let me proceed while I wait for their response on how to deal with those part issues.

- [ ] C10
- [ ] C54
- [ ] D1
- [ ] D2
- [ ] L16

kb1lqc, 2016-11-19:
What do I do about Fiducials?

kb1lqc, 2016-11-21:
D1 and D2 used different PN's and worked...

D1: 475-3118-1-ND
D2: 475-3124-1-ND

kb1lqc, 2016-11-21:
C10 and C54 worked

C10: 490-10961-1-ND
C54: 490-10961-1-ND

kb1lqc, 2016-11-21:
Fiducials are not used by PCB:NG apparently. Well they are there if they need better alignment. They use their own on the panels they create. Apparently that's good enough for our QFN's, we will see!

kb1lqc, 2016-11-21:
L16 Coilcraft LPS4018-472MRB

Per PCB:NG this is a bit of a hack for now. Since they deal with digikey only for online system orders we need to work around it for now.

- Replaced L16 with a unique zero ohm jumper
- Use IC orientation to obtain correct part placement
- When we order, indicate this part swap in the order ticket and wait for separate invoice since their system doesn't handle non-digikey parts.

kb1lqc, 2016-11-21:
On new PCB:NG project I used:

L16: YAG1232TR-ND

Thread 44 (2016-12-05):

Soldermask on L16 looks like it Impinges a Bit on Pads

kb1lqc, 2016-12-05:
Self explanatory
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
* Not too worried but the Rev B OSHpark boards didn't do this. Will be interesting to investigate if the soldermask gerbers actually show this being present or not.

Thread 45 (2016-12-11):

Rev D1 - Initial Boot

kb1lqd, 2016-12-11:
Booting of the first REV D1 PCBA from PCB:NG. This board has no through hole components, GPS, or SMA antenna connector until it is soldered at a later time. This ticket is to capture the boot process.

**Initial Steps Needed**
* Plug into USB and verify proper USB recognition
* Determine USB virtual COM port
* Build firmware .TITXT HEX file for bootloading
* Program with bootloader and verify non-RF portions of the hardware

Thread 46 (2016-12-11):

REV D1 - Initial Build Notes (First Article)

kb1lqd, 2016-12-11:
This ticket holds the inspection, build, and testing of the first PCBA to be built 100% to completion. As arrived from PCB:NG the PCBA's contain all circuitry except through hole components, GPS, and SMA connector. During inspection several key verification need to be addressed:

* Inspect all solders across the boards builds
  * Note any cold solders, suspiciously small solder fillets, etc...
* Verify electrical operation
  * CC430
    * [Initial bootloader programming](https://github.com/FaradayRF/FaradayRF-Hardware/issues/45)
  * Power Supply
  * USB/UART
  * GPS
  * CC1190
  * Antenna Output

Thread 47 (2016-12-12):

First Batch Rev D1 Build

kb1lqc, 2016-12-12:
# First Batch Boards
We've already brought up the first of twelve boards on #46 so here are the next 11! Order of building these units will be the same as the first being SMA connector, GPS, and finally Power/MOSFET connectors. None of them will initially get a JTAG connector but they may eventually. Finally I will use prebuilt binaries to update the firmware of the CC430 via USB.

kb1lqc, 2016-12-12:
Just finised placing and soldering all 11 SMA connectors with hand-placed solder paste and reflow. This took about 54 minutes so 4.9 minutes per board.

kb1lqc, 2016-12-12:
I'll make a second Issue Ticket and post images but 2/11 boards have some poor solders on U1, the CC430F6137. It appears there was too much solder and some pads balled up or flowed between each other. Good to note so any manufacturing tweeks can be made to prevent this!

- [ ] Create Issue Ticket with images for U1 solder quality

kb1lqc, 2016-12-12:
Installing five GPS units took 30 minutes with a littler rework after reflow. This turned out to be about 6 minutes per board. Largely due to too much solderpaste resulting in the need to remove solder from most of the 28 pins per GPS which was time consuming.

kb1lqc, 2016-12-12:
Installing 22 power/mosfet connectors on 11 boards took 15 minutes. This equates to 41 seconds per connector or 1:21 per board.

kb1lqc, 2016-12-12:
Cleaning boards after soldering took about 20 minutes for 11 boards which equals about 1:50 per board.

kb1lqc, 2016-12-12:
Plugged first unit in, SN2, and it appears as COM11. Reprogrammed with FTDI PRog and it's now COM12.

Needed to program with FT-PROG
 * Set max power to 500mA
 * Set CBUS configuration to all GPIO

Programmed firmware on via python autouploader and LED's appear to boot on fine.

kb1lqc, 2016-12-12:
Took roughly 35 minutes to program 11 units with the autoupdater script and FT-PROG

kb1lqc, 2016-12-12:
SN 8 just got a GPS lock, SN 11 also connected after being left for a while turned on.

kb1lqc, 2016-12-12:
While I haven't extensively tested these I think it's safe to say that for the most part they appear to work.

Thread 48 (2016-12-12):

Faraday Rev D1 SN 2 - SN 11 Build Solder Notes

kb1lqc, 2016-12-12:
[Faraday_PoorSolders.zip](https://github.com/FaradayRF/FaradayRF-Hardware/files/645487/Faraday_PoorSolders.zip)

The attached zip folder contains images showing some poor U1 CC430 solders I discovered today while building up the last 11 units of this test build. Lots of solder beads and some shorts. An example below:

![Uploading IMG_7235_edited.JPG…]()

I'll let PCB:NG know so they can adjust any solder or paste manufacturing profiles to prevent this.

kb1lqc, 2016-12-12:
Also, please not the "Solder Inspection" notes we took on our first article build of Faraday:

https://github.com/FaradayRF/FaradayRF-Hardware/issues/46

Thread 49 (2017-01-22):

Test External Power (9V) Cable Connected to MOSFET Connector P3

kb1lqc, 2017-01-22:
Title says it all. Analysis indicates that Ground would be  connected to the MOSFET drain and VCC would be connected to VCC correctly. This was done by design. At most I expect the body diode of the MOSFET to allow conduction and powering of Faraday. Passing 30mA during GPS + RX should be fine while transmitting could cause damage to the MOSFET. The groundshift could cause unexpected operations but should not cause damage.

kb1lqc, 2017-02-15:
OK I'm revisiting this. I've attached a Faraday Rev B (Purple PCB) SN 3 to an external 9V supply.  The VCC input is very similar. SN 3 does not have Rev B U11 populated while SN 1 does. I would like to keep this as similar as possible.

**Rev B**
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

**Rev D1**
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

And the connectors are the same for VCC and MOSFETs

**Rev B**
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

**Rev D1**
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

kb1lqc, 2017-02-15:
The MOSFET circuit is the same as well.

**Rev B**
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

**Rev D1**
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

kb1lqc, 2017-02-15:
By design I suspect that the MIC94072YC6 on Rev B will not stop any reverse conduction. However it is coming from USB so we shouldn't need to worry as USB is very polarized, you would need to really try to reverse that polarization.

The VCC input is protected the LTC4412 with the auxiliary PMOS (Q4 on Rev B and Q3 on Rev D1). The LTC4412 should protect against a reverse polarity by turning off the PMOS and the internal body diode will be reverse biased.

The immediate question is whether connection of VCC power to the MOSFET will cause damage. By design the polarized connections are the same but force VCC to always be Pin 1 on the power connection as well as MOSFET. No issue here. The GND will however attach to the NMOS drain. The body diode will be forward biased as GND will be attached to the cathode as shown above. This means that the effect will be the same as placing a diode between ground and a battery.

**Pros**

- Faraday should actually still work
- No damage should result unless we violate the NMOS transistor body diode power rating.

**Cons**

- Faraday's ground will be a diode drop above battery ground (DGND and shield)
- Could cause ground loops and extra current drain when connected to externally grounded items.
- NMOS will dissipate heat during normal operation of Faraday when it shouldn't be.

Actually, I am not totally sure what will happen if the NMOS is turned on while VCC is plugged into the MOSFET connection. At first look, the worst-case is the NMOS is non-function because gate voltage may not get high enough and best-case the diode drop goes toward 0V due to Rdson with a saturated NMOS!

IRLML6346TRPbF Transistor
[Datasheet](http://www.infineon.com/dgdl/irlml6346pbf.pdf?fileId=5546d462533600a401535668a336262e)

This can withstand 1.3A continuous through the body diode... this means Faraday without modifications or external current sinking should cause no damage to the body diode!

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

As shown on the right, the body diode cathode connects to the NMOS drain.

kb1lqc, 2017-02-15:
**Faraday Rev B SN 3**
This is using an old firmware but should be mostly relevant. This radio has an Antennova GPS installed.

_Nominal VCC Connection @ 9V_
Steady State Current (Boot-up): 22mA
Steady State Current (GPS Lock): 21mA

_MOSFET VCC Connection @ 9V_
Steady State Current (Boot-up): 23mA
Steady State Current (GPS Lock): 24mA

Yup! As expected Faraday turned on when VCC cable was plugged into the MOSFET connection! Hell yeah @kb1lqd! This is only for correctly oriented voltages. However in aerospace terms we're already at one fault :) and therefore are one fault tolerant hehe.

kb1lqd, 2017-02-15:
Connect to USB at same time? I suspect nothing interesting...

kb1lqd, 2017-02-15:
Also, make sure to confirm on a REV D1.

kb1lqc, 2017-02-15:
While 9V is connected to the MOSFET connector, I measured 8.33V or 670mV less than the power supply. Exactly where I'd expect it to be since that's a silicon diode drop!

kb1lqc, 2017-02-15:
Awesome, confirmed that while VCC connected to MOSFET connector the USB connection still works. At least it identifies as a serial port in Windows.

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

kb1lqc, 2017-02-15:
Removing VCC from MOSFET while USB connected showed no signs of alternate operation other than intended smooth power switching.

kb1lqc, 2017-02-15:
I put 17V on the power supply and connected in to both power and MOSFET connectors, unit operated as expected in these conditions. I did hear an audible click with my Rev B unit but likely the TPS562201DDCR ramping up.

kb1lqc, 2017-02-15:
Placing 17V reverse polarity across VCC input resulted in no damage. Faraday was obviousy non-functional but restoration of USB power or VCC power with correct polarity after the fault showed nominal operation.

I would however caution that I did not test inverted VCC power with USB connected. While this should be OK with a floating VCC (non-grounded battery or isolated power supply) there could be problems if the external supply is referenced to the same ground as the computer. If the computer is floating (laptop on battery power) then you should be good to. However these are not tested. I simply don't want to try that right now on my computer.

kb1lqc, 2017-02-15:
**Rev D1**

I placed 17V across VCC and all worked fine. Additionally, 17V across the MOSFET connector also worked fine. Both LEDs blinked during bootup in both cases. I did not measure current and this unit did not have a GPS (SN 40) but that isn't relevant to this test. We shouldn't expect to see immediate failures from an incorrect connection.

kb1lqc, 2017-02-15:
Alright I'm done. I tested Rev D1 SN 40 with reverse polarity 17V (isolated) into both VCC and MOSFET connections. This resulted in no observable power supply current (rough, no DMM) and when 9V was reapplied from a battery correctly oriented nominal operation resumed.

Users should be able to plug an isolated (bench-top) supply or 9V battery in backwards or into MOSFET and not cause damage in this single-fault scenario.

With two faults such as reverse polarity VCC and a power supply plugged into MOSFET we believe nothing should happened due to the LTC4412 but cannot guarantee it and it's untested. We can only protect you from so much. So far, I like the design, Faraday connectors for VCC and MOSFET are reversible without causing any obvious damage. Plug and play without having different connectors or oddly placed connectors.

Closed 2017-02-15.

Thread 50 (2017-02-10):

Create a table of specifications

jbemenheiser, 2017-02-10:
A full blown datasheet is not necessary at this point, but a single table to reference for the standard operating parameters of the board would be helpful.

kb1lqc, 2017-03-05:
I just took some quick measurements with the current [firmware master V0.1.2-alpha](https://github.com/FaradayRF/Faraday-Firmware/releases/tag/v0.1.2-alpha). I plan on taking much more strenuous voltage/current/power measurements but I do not have the time right now.

It is important to remember absolutely zero effort has been put into power saving with firmware configuration!

## No GPS Receive Steady State
Vin = 9.00V
Iin = 0.0113A
Pin = 0.102W

## GPS Receive Steady State (Locked)
Vin = 9.00V
Iin = 0.0209A
Pin = 0.188W

No observable difference was seen from GPS locked to unlocked so I won't bother documenting it right now. These measurements do not include TX pulses. We will have to specifically test for TX power later. I did not account for wire losses but they should be extremely small at these currents.

Thread 51 (2017-07-09):

Generate 3-view Mechanical Drawing of PCB with Components

markwiem, 2017-07-09:
Ideally this would be viewable in the `FaradayRF-Hardware/Mechanical/Drawings` (or similar) folder without the need to pull down zips, enter KiCad, etc. Critical to enthusiasts who want to know how to mount FaradayRF in an enclosure.

I noticed the hole patter of the FaradayRF is not regular (ie 4"x4", etc.). I would be happy to generate a 3D printed adapter (`FaradayRF-Hardware/Mechanical/CAD/Mounts`) to transverse the irregular PCB mounts to an "easy to measure out and manufacture at home" variety.

Later revisions of the board may want to consider evolving mounts to a symmetrical pattern. I completely understand the challenge of doing this real-world.

kb1lqc, 2017-07-09:
Yes this should be a thing! Thanks for bringing this up. One note, the hole pattern is purposefully irregular so you can't get mounting orientation backwards. An adapter would definitely be useful too for uses when this isn't an issue.

kb1lqd, 2017-07-09:
I will second or third it that at least a mechanical drawing about to
output hole patterns would be great. I've eye baked it when drilling
mounting holes in my base station for Faraday but this is not easy or high
quality.

What tools do you think we can use?

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

markwiem, 2017-07-10:
I know that some PCB layout tools provide CAD export in `.STEP` or `.stl` format. Looking at KiCad, it doesn't seem that this can be performed natively, but there is a StepUp tool that could potentially work for us here (https://forum.kicad.info/t/how-to-share-step-3d-model-with-all-the-components-on-the-pcb-too/2542).

If StepUp worked, I should be able to import the model into a CAD suite and generate basic drawings with dimensions. I'm not going to go as far as to say having a PCB CAD export is required for this, as we could could generate decent enough dimensional drawings from high res pics of the board.

In terms of generating a mounting adaptor, I'm proposing using Fusion 360. It is free for makers as long as income restrictions are met (see: https://www.autodesk.com/products/fusion-360/overview -- scroll to "Collaborate and Manage"). There would be no licensing fees associated with the board, if it ever looked like volume/revenue could make this a (good!) problem, then you could whip up a clone in a licensed version and be set. Let me know if you feel comfortable with this strategy.

To get started on the mounting adaptor, a basic photo with measure overlayed would be sufficient, it could even be a napkin drawing dropped in this thread :)

kb1lqc, 2017-07-11:
Yeah Faraday Hardware is currently designed on the older Kicad 2013 Stable too... it's a huge deal for me to update the libraries. Figured next rev of the board.I wonder if it's possible to import at least the gerbers or something into a CAD tool. I know I don't have many 3D parts in the 2013 library.This makes me look forward to moving to the new Kicad. It will definitely be more stable than when we designed this board 😉---- On Sun, 09 Jul 2017 21:15:12 -0700  Mark Wiemer<notifications@github.com> wrote ----I know that some PCB layout tools provide CAD export in .STEP or .stl format. Looking at KiCad, it doesn't seem that this can be performed natively, but there is a StepUp tool that could potentially work for us here (https://forum.kicad.info/t/how-to-share-step-3d-model-with-all-the-components-on-the-pcb-too/2542). If StepUp worked, I should be able to import the model into a CAD suite and generate basic drawings with dimensions. I'm not going to go as far as to say having a PCB CAD export is required for this, as we could could generate decent enough dimensional drawings from high res pics of the board. In terms of generating a mounting adaptor, I'm proposing using Fusion 360. It is free for makers as long as income restrictions are met (see: https://www.autodesk.com/products/fusion-360/overview -- scroll to "Collaborate and Manage"). There would be no licensing fees associated with the board, if it ever looked like volume/revenue could make this a (good!) problem, then you could whip up a clone in a licensed version and be set. Let me know if you feel comfortable with this strategy. To get started on the mounting adaptor, a basic photo with measure overlayed would be sufficient, it could even be a napkin drawing dropped in this thread :)  —You are receiving this because you commented.Reply to this email directly, view it on GitHub, or mute the thread.

Thread 52 (2018-08-11):

GPS M10478-A2 has gone obsolete, substitute M20050-1?

mmagin, 2018-08-11:
Hi, interested in your opinion and I imagine you'll have to make a similar change anyway in the future:

After your Amp Hour appearance, I got impatient for waiting, so I'm building two or three FaradayRF boards based on the REV D board layout.  Aside from some careful MLCC substitutions (!@#$%) and the SPI flash that's DNP (and which looks like a standard interface), the significant thing that I couldn't obtain was the GPS M10478-A2 module.  An EOL notice from Antenova says to use the M20048, which Digikey didn't have, but I went looking at the M20050-1 and it seems to also be a compatible pinout, except for wanting a 1.8 nH inductor between pin 28 and GND and having a somewhat different antenna.  I am actually tempted to just put one in the existing circuit and see how it performs, though I could probably isolate the pad with kapton and bodge in a tiny wire. :)

Thanks!
