FaradayRF/FaradayRF-Hardware/Kicad-Faraday/OutputFiles/FaradayRF-SCH.pdf

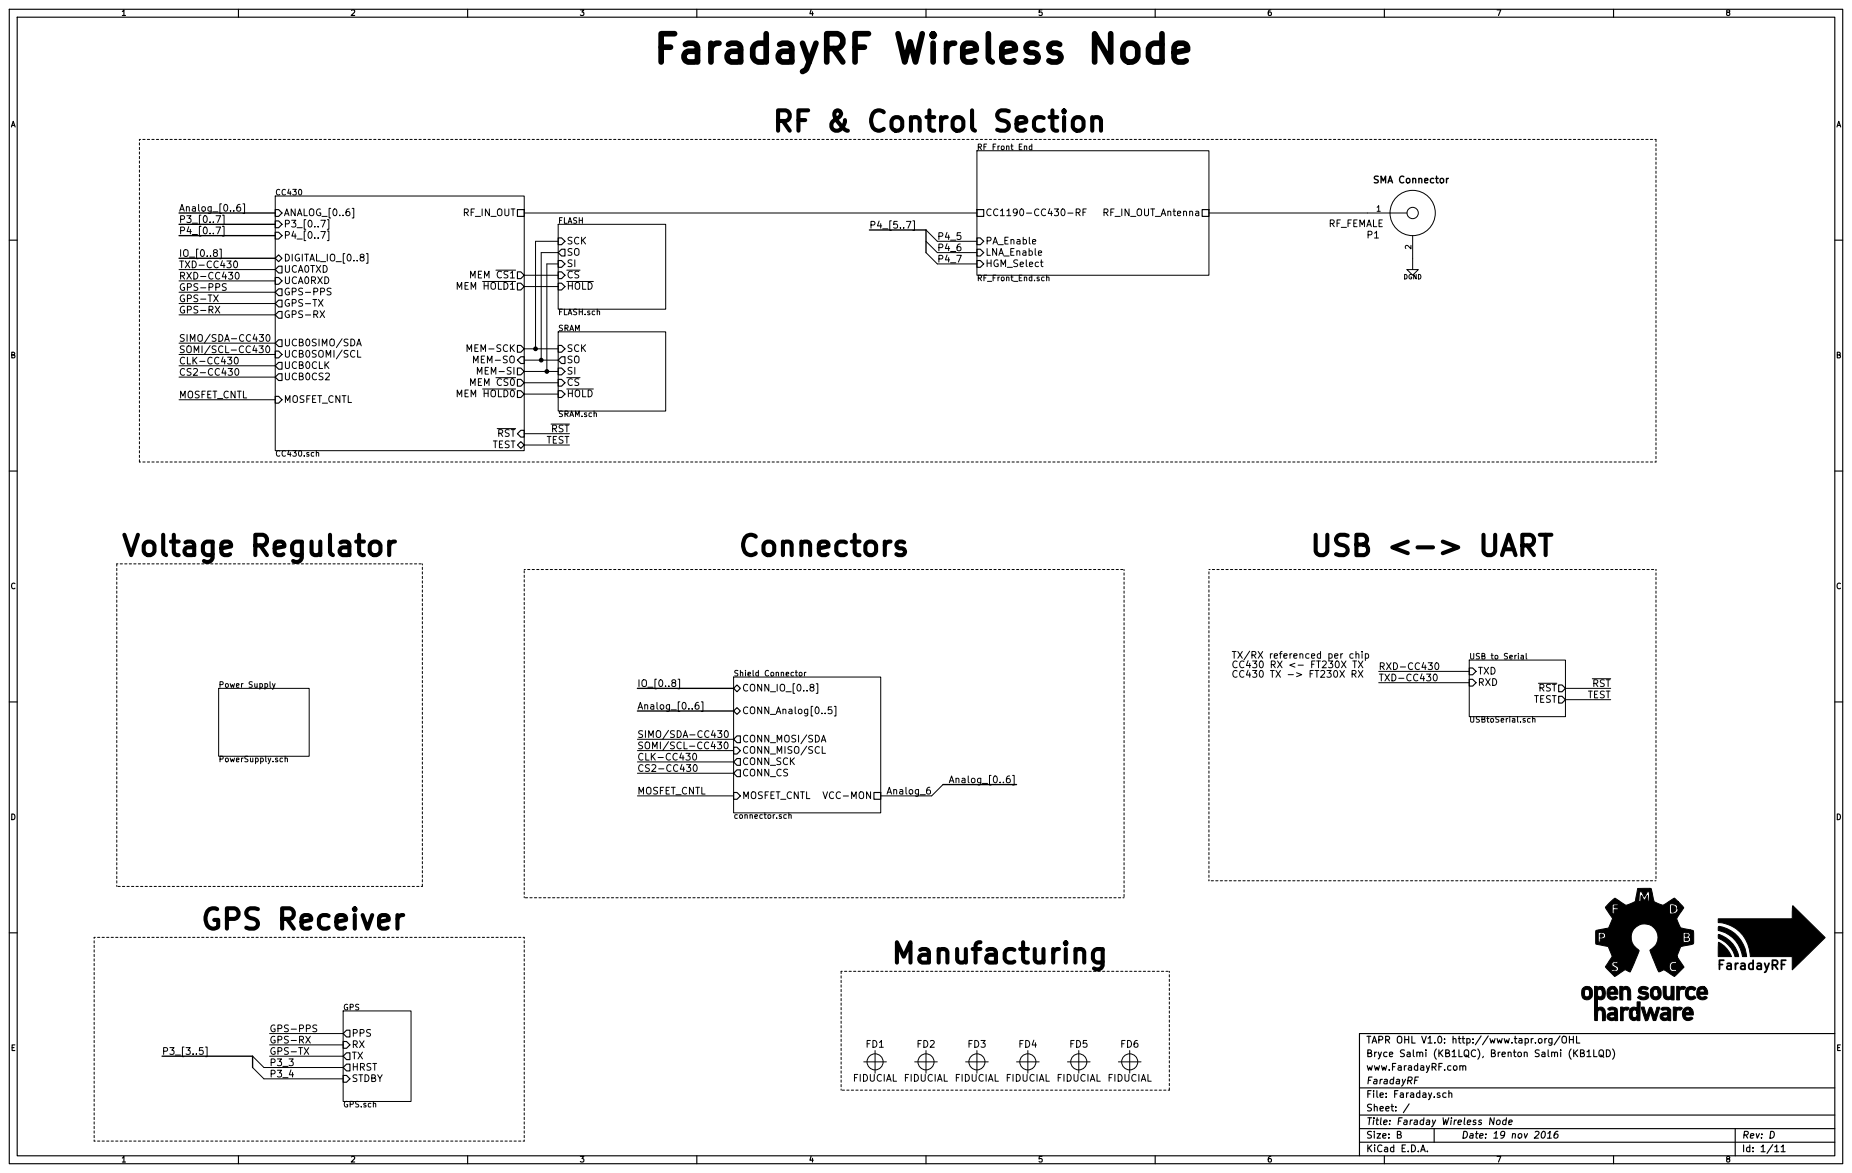
[picture p1: page 1]

TX/RX referenced per chip

Shield Connector connector.sch MOSFET_CNTL

GPS GPS.sch RX

TAPR OHL V1.0: http://www.tapr.org/OHL
Bryce Salmi (KB1LQC), Brenton Salmi (KB1LQD)
www.FaradayRF.com
FaradayRF
File: Faraday.sch
Sheet: /
Title: Faraday Wireless Node

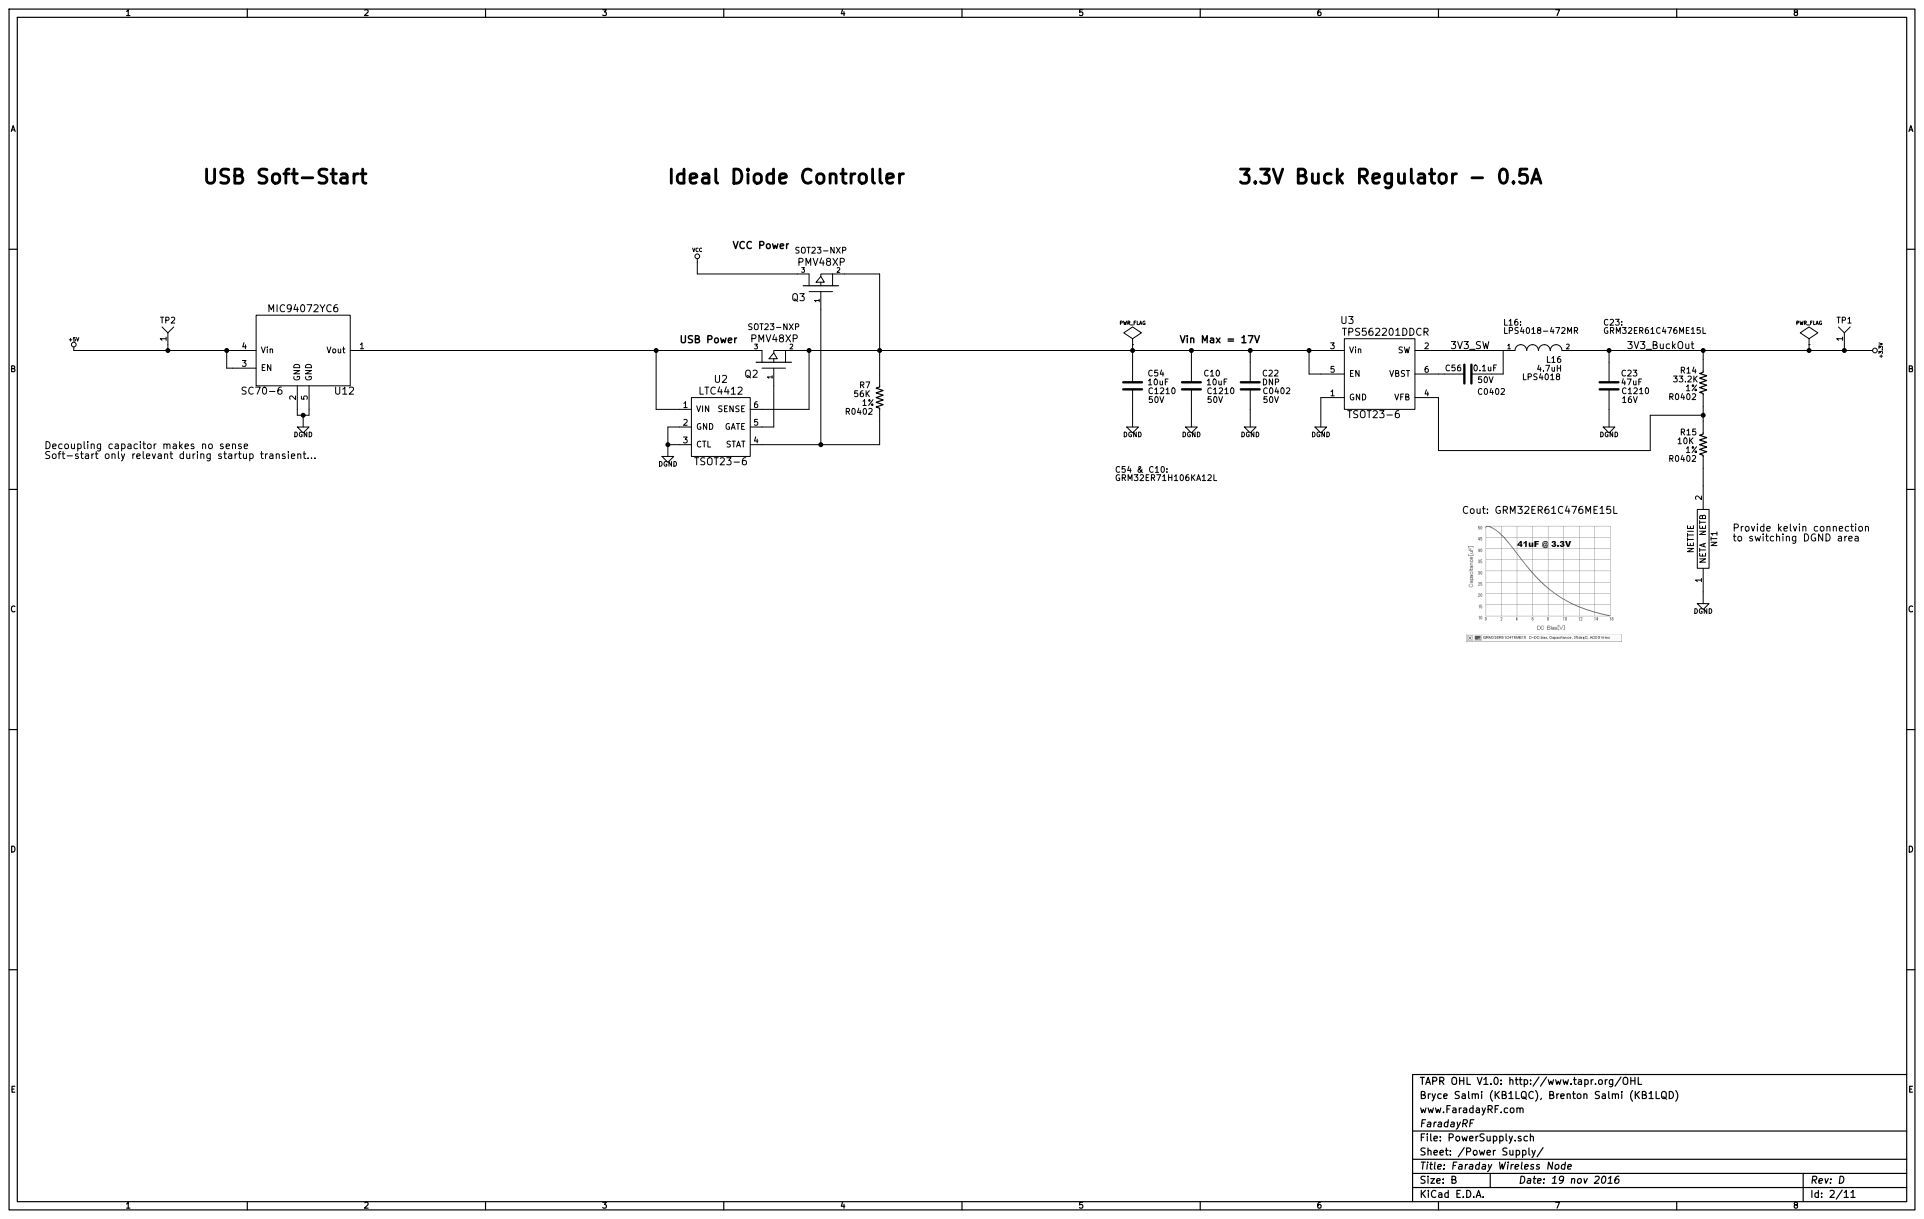
[picture p2: page 2]

1 TP1 GND 1 SW 2 Vin 3 VFB 4 EN 5 VBST 6 U3TPS562201DDCR

to switching DGND area

TAPR OHL V1.0: http://www.tapr.org/OHL
Bryce Salmi (KB1LQC), Brenton Salmi (KB1LQD)
www.FaradayRF.com
FaradayRF
File: PowerSupply.sch
Sheet: /Power Supply/

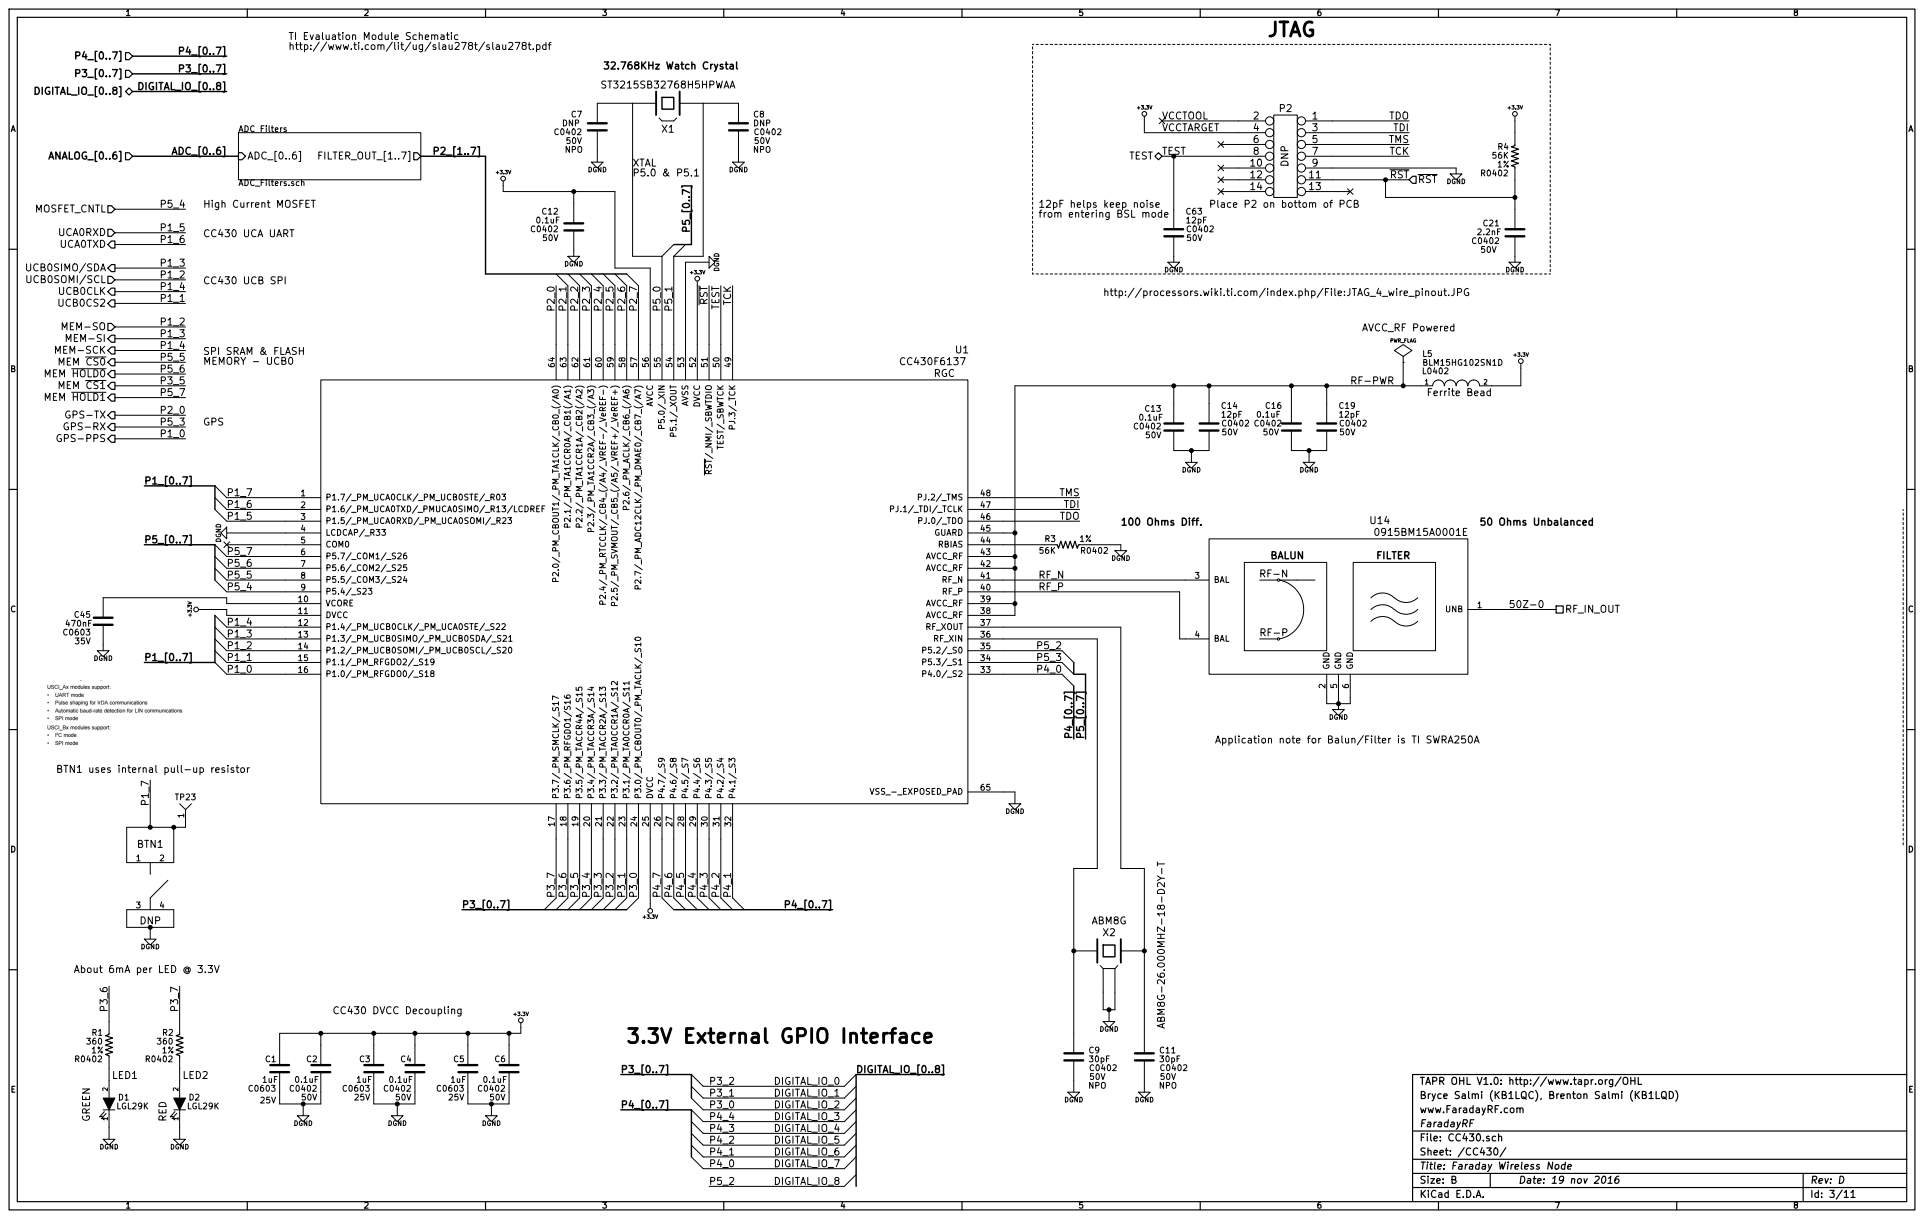
[picture p3: page 3]

50V TI Evaluation Module Schematic

http://www.ti.com/lit/ug/slau278t/slau278t.pdf C45

from entering BSL mode

50V http://processors.wiki.ti.com/index.php/File:JTAG_4_wire_pinout.JPG

1 TP23 Application note for Balun/Filter is TI SWRA250A BALUN FILTER

TAPR OHL V1.0: http://www.tapr.org/OHL
Bryce Salmi (KB1LQC), Brenton Salmi (KB1LQD)
www.FaradayRF.com
FaradayRF
File: CC430.sch
Sheet: /CC430/

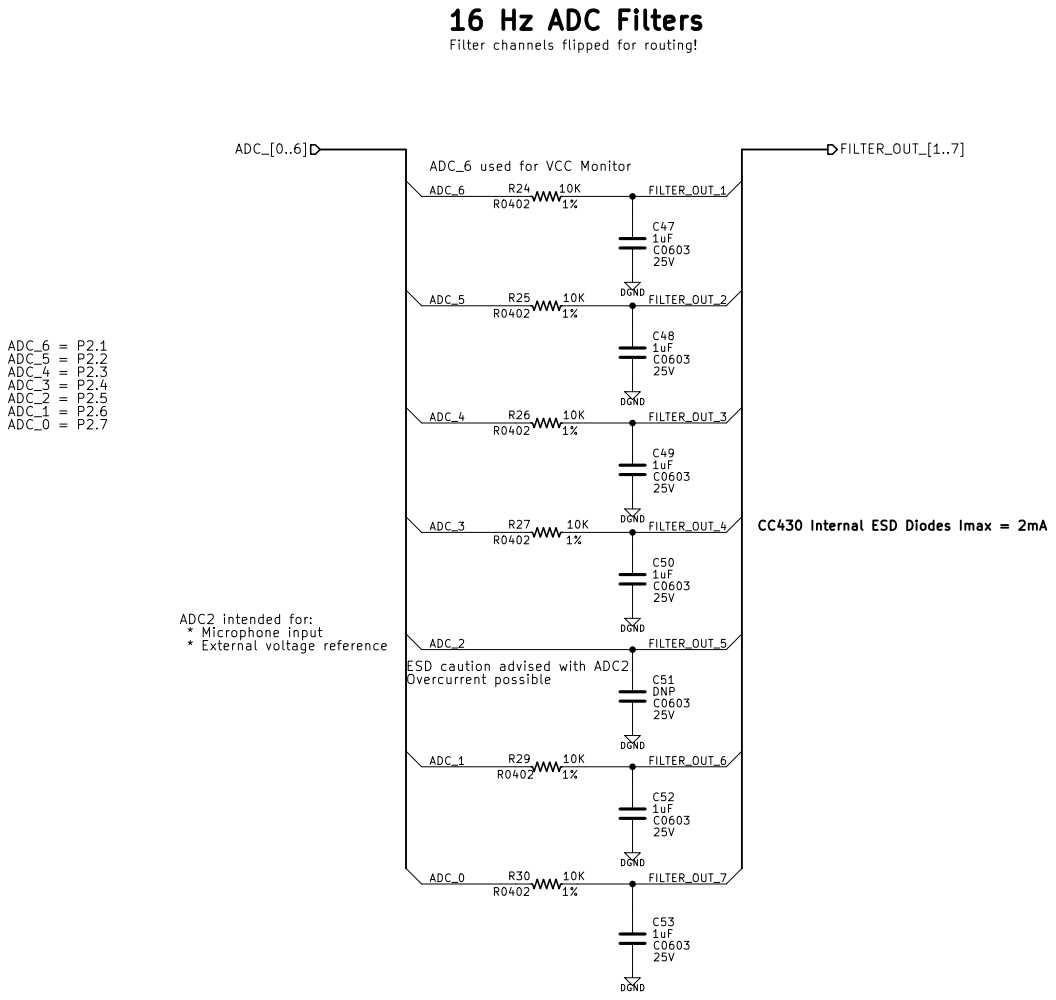
[picture p4: page 4]

Filter channels flipped for routing!

ADC_6 used for VCC Monitor

CC430 Internal ESD Diodes Imax = 2mA

ESD caution advised with ADC2
Overcurrent possible

TAPR OHL V1.0: http://www.tapr.org/OHL
Bryce Salmi (KB1LQC), Brenton Salmi (KB1LQD)
www.FaradayRF.com
FaradayRF
File: ADC_Filters.sch
Sheet: /CC430/ADC Filters/

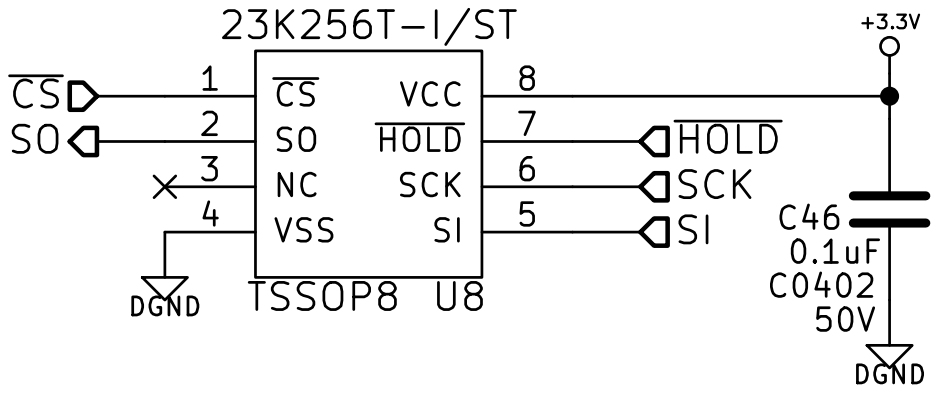
[picture p5: page 5]

TAPR OHL V1.0: http://www.tapr.org/OHL
Bryce Salmi (KB1LQC), Brenton Salmi (KB1LQD)
www.FaradayRF.com
FaradayRF
File: SRAM.sch
Sheet: /SRAM/

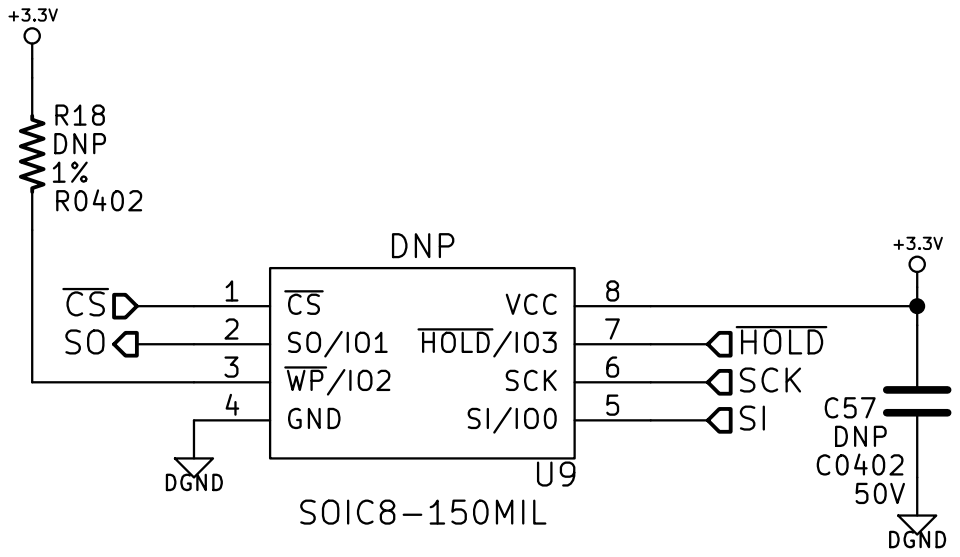
[picture p6: page 6]

TAPR OHL V1.0: http://www.tapr.org/OHL
Bryce Salmi (KB1LQC), Brenton Salmi (KB1LQD)
www.FaradayRF.com
FaradayRF
File: FLASH.sch
Sheet: /FLASH/

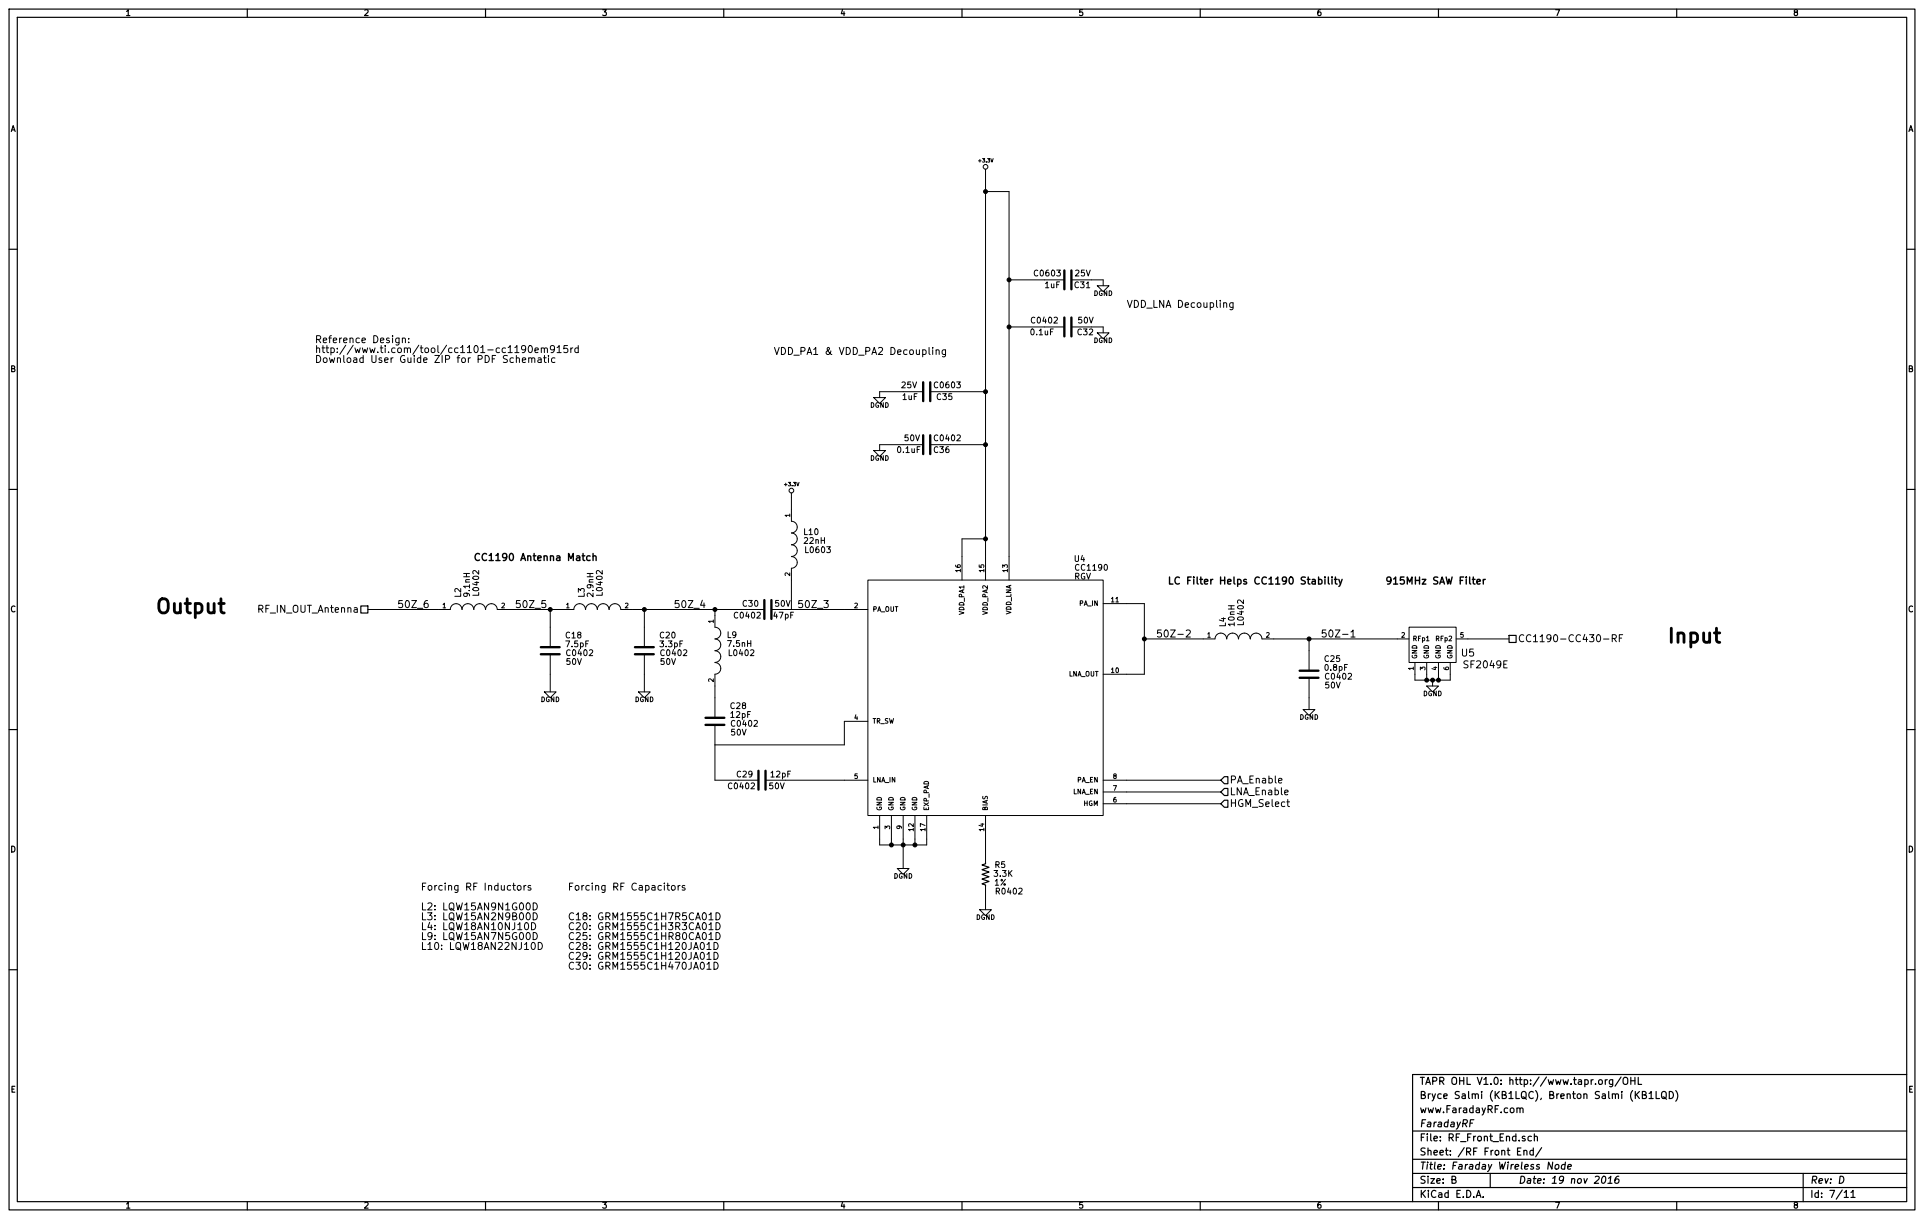
[picture p7: page 7]

DGND Forcing RF Inductors

Reference Design:
http://www.ti.com/tool/cc1101-cc1190em915rd

LC Filter Helps CC1190 Stability

TAPR OHL V1.0: http://www.tapr.org/OHL GND

Bryce Salmi (KB1LQC), Brenton Salmi (KB1LQD)
www.FaradayRF.com
FaradayRF
File: RF_Front_End.sch
Sheet: /RF Front End/

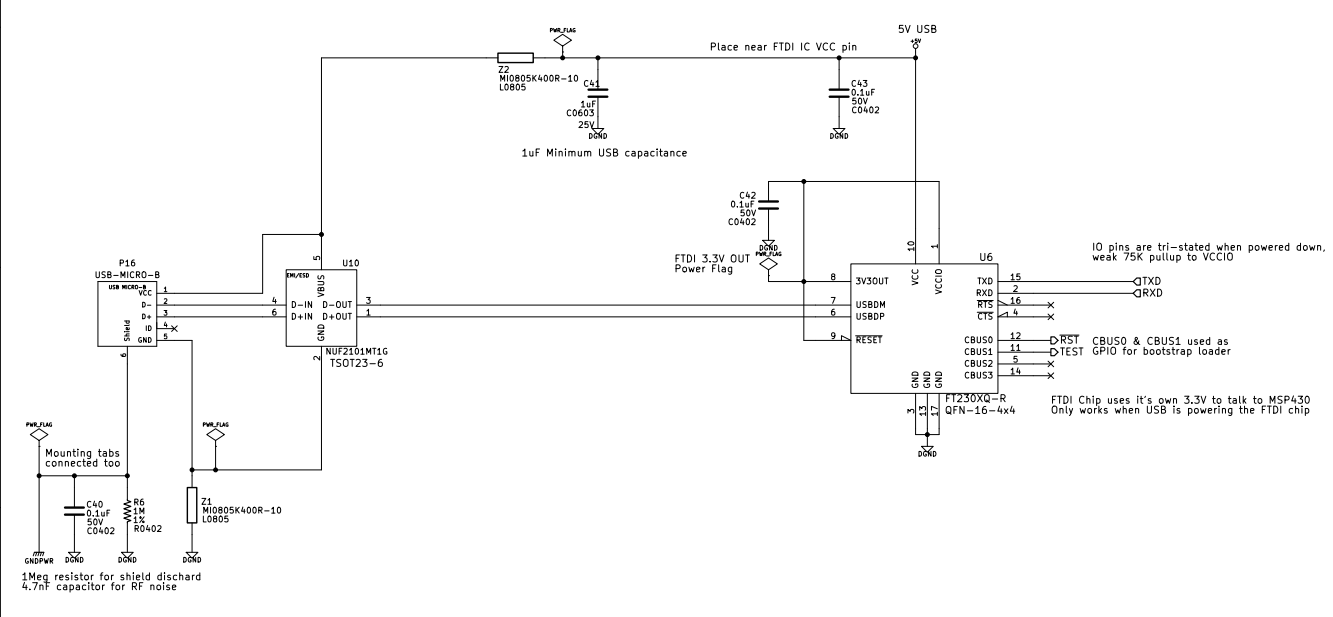
[picture p8: page 8]

50V Place near FTDI IC VCC pin R6

DGND 1uF Minimum USB capacitance

IO pins are tri-stated when powered down,
weak 75K pullup to VCCIO

Only works when USB is powering the FTDI chip

1Meg resistor for shield dischard
4.7nF capacitor for RF noise

TAPR OHL V1.0: http://www.tapr.org/OHL
Bryce Salmi (KB1LQC), Brenton Salmi (KB1LQD)
www.FaradayRF.com
FaradayRF
File: USBtoSerial.sch
Sheet: /USB to Serial/

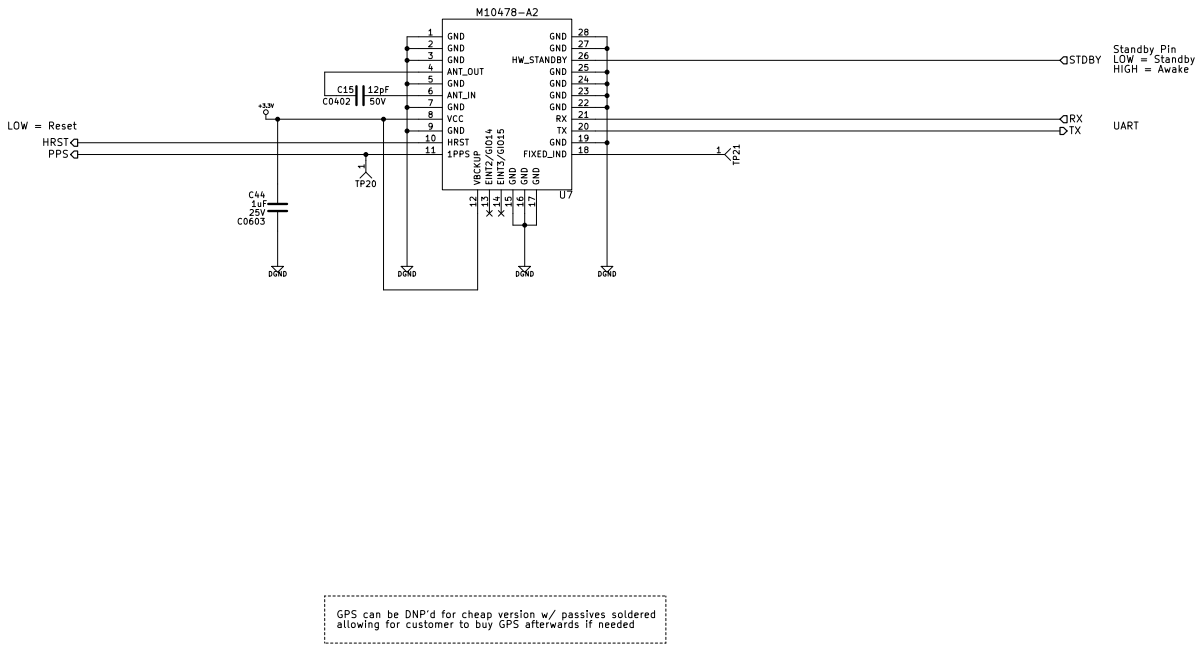
[picture p9: page 9]

allowing for customer to buy GPS afterwards if needed

TAPR OHL V1.0: http://www.tapr.org/OHL
Bryce Salmi (KB1LQC), Brenton Salmi (KB1LQD)
www.FaradayRF.com
FaradayRF
File: GPS.sch
Sheet: /GPS/

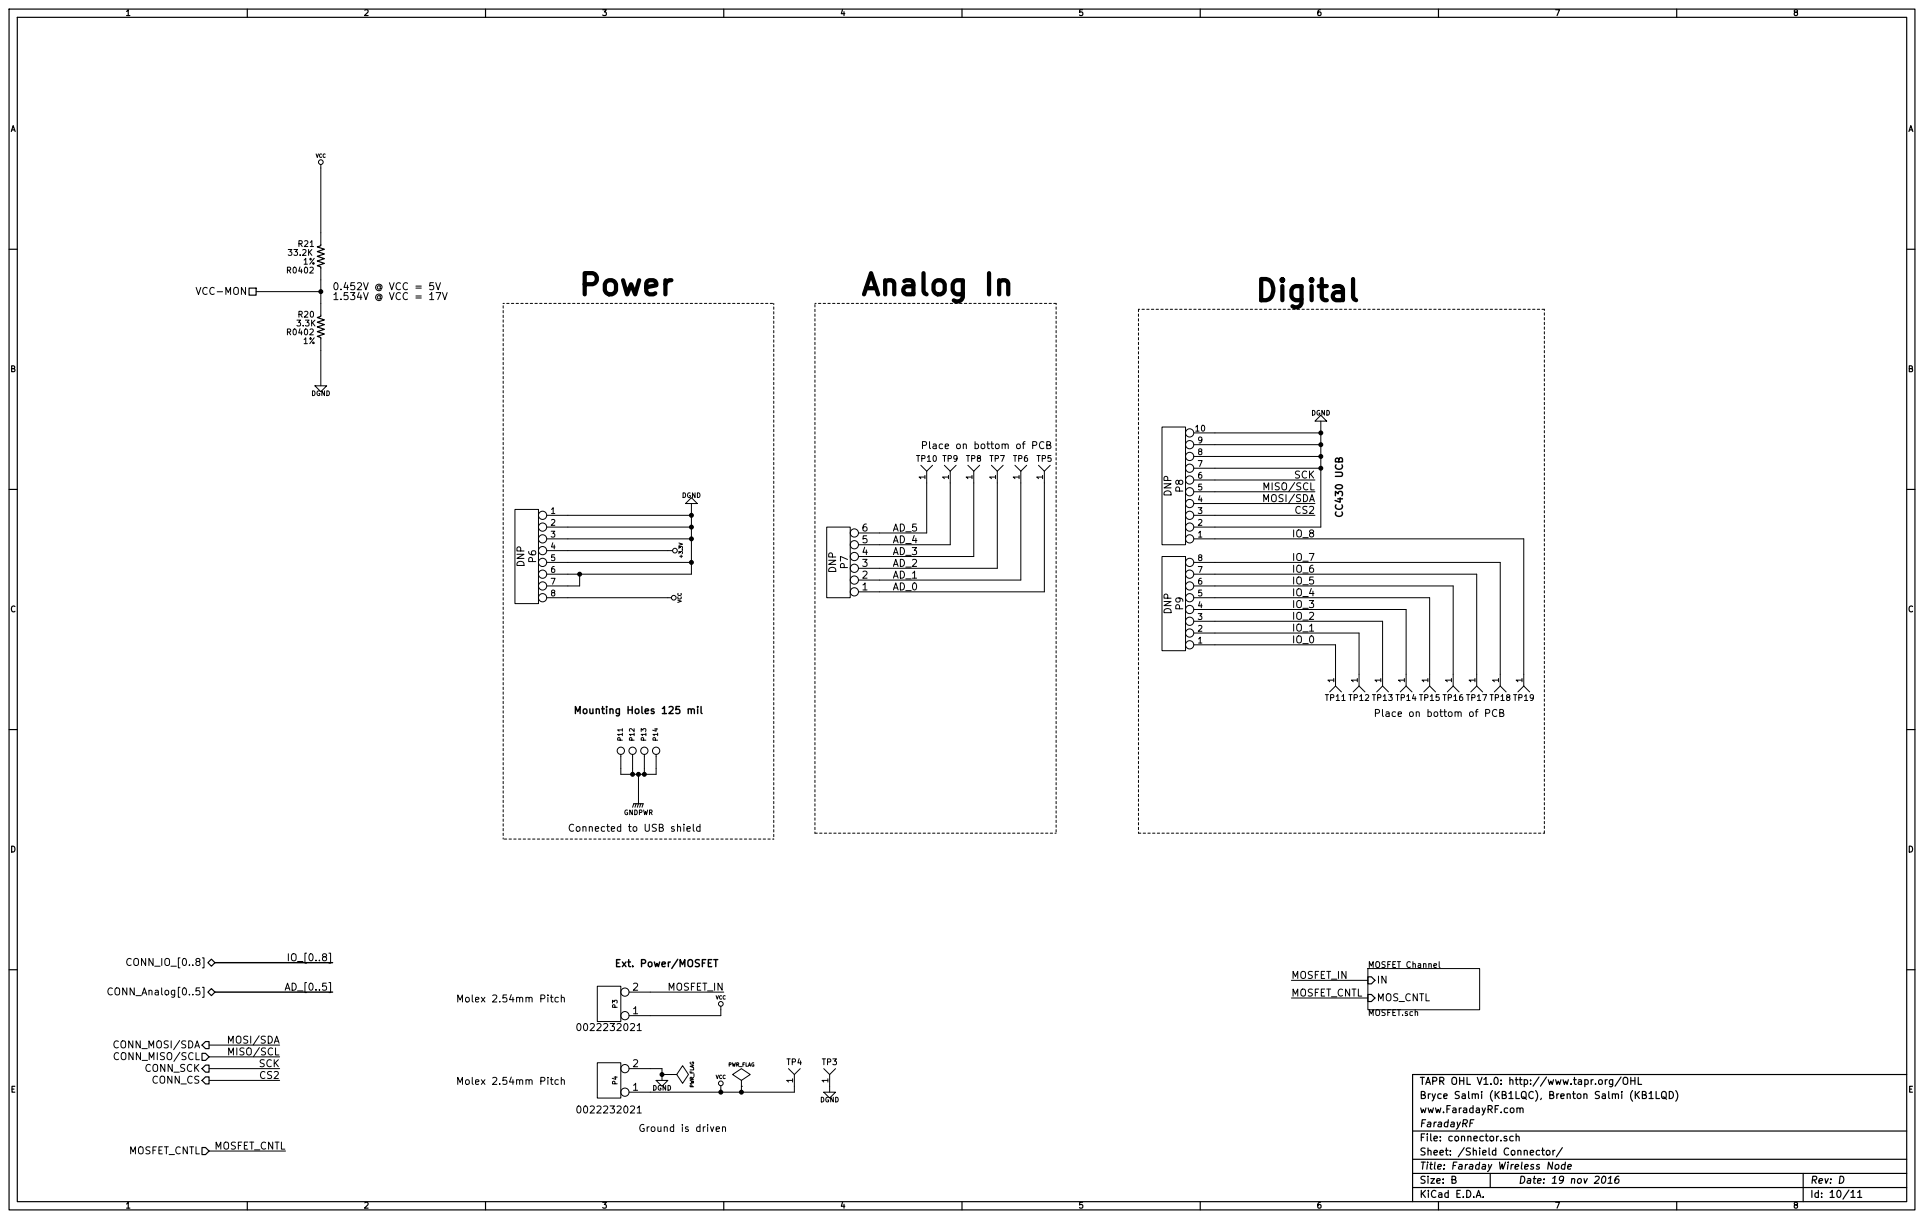
[picture p10: page 10]

Place on bottom of PCB

1 TP17 Place on bottom of PCB

TAPR OHL V1.0: http://www.tapr.org/OHL
Bryce Salmi (KB1LQC), Brenton Salmi (KB1LQD)
www.FaradayRF.com
FaradayRF
Title: Faraday Wireless Node File: connector.sch Sheet: /Shield Connector/

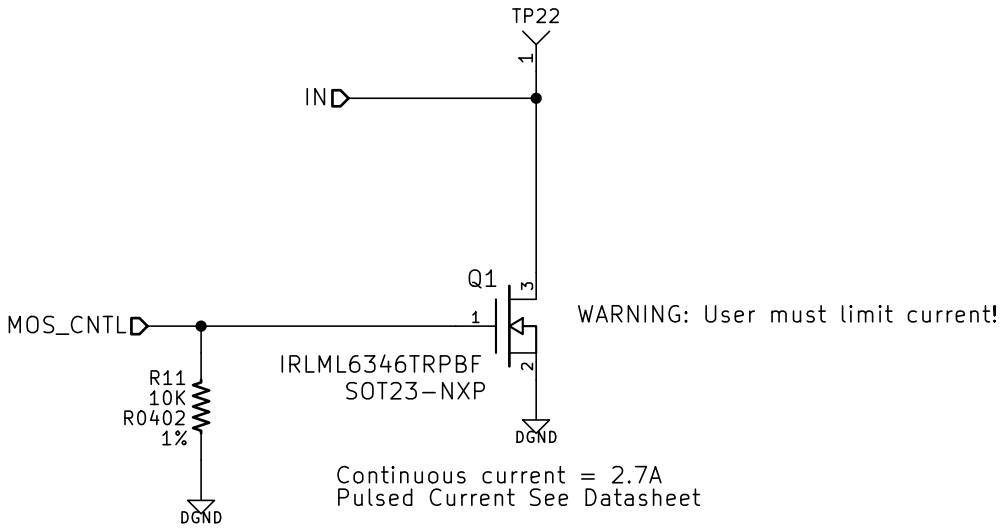
[picture p11: page 11]

Pulsed Current See Datasheet DGND
Continuous current = 2.7A

TAPR OHL V1.0: http://www.tapr.org/OHL
Bryce Salmi (KB1LQC), Brenton Salmi (KB1LQD)
www.FaradayRF.com
FaradayRF
File: MOSFET.sch
Sheet: /Shield Connector/MOSFET Channel/
