FaradayRF/FaradayRF-Hardware/EngineeringDocs/LTC4412IdealDiode.asc

C1: cap; 10µ
C2: cap; 1µ
Cdamp: res; 2
Q1: PMOS; FDC638P
Q2: PMOS; FDC638P
R1: RES; 470K
Rload: res; 100
U1: LTC4412
V1: VOLTAGE; 5
V2: voltage; PULSE(0 12 0.5 100u 100u 200m)
Named nets: 0, OUT
.tran 1
