FaradayRF/FaradayRF-Hardware/EngineeringDocs/USB_Soft-Start.asc

C1: cap; 18p; Rser=10m
C2: cap; 22µ; Rser=10m
C3: cap; 10µ; Rser=10m
C4: cap; 0.1µ; Rser=10m
C5: cap; 0.2µ; Rser=10m
C6: cap; 22µ; Rser=10m
M1: pmos; Si7540DP_P
R1: res; 470k
R2: res; 44
R3: res; 15.2
R4: res; 470k
R5: res; 15.2
R6: res; 0.12
V1: voltage; PULSE(0 5 100m 0.01m)
V2: voltage; PULSE(0 5 100m 0.1m)
V3: voltage; PWL(0 0 100m 0 100.8m 5)
Named nets: 0, VUSB1, VUSB0
.tran 0 150m 90m
Soft-Start
FaradayRF Load
USB Specification Load
FaradayRF Load
