FaradayRF/FaradayRF-Hardware/EngineeringDocs/USBFiltering.asc

C2: cap; 10µ; Rser=10m
C4: cap; 10µ; Rser=10m
I1: current; ""; AC 1
I2: current; ""; AC 1
L1: ind; 4.7µ; Ipk=1.9 Rser=0.1075 Rpar=442.74 Cpar=0 mfg="Coilcraft" pn="LPS4018-472"
L2: ind; 4.7µ; Ipk=1.9 Rser=0.1075 Rpar=442.74 Cpar=0 mfg="Coilcraft" pn="LPS4018-472"
R1: res; 2
R2: res; 2
R3: res; 2
Rload: res; 19
V1: voltage; ""; AC 1
Named nets: 0, Vin, Vload, VCC
.ac oct 100 1 2G
Short input to ground for this test!
FaradayRF Power Supply Filtering
.step param R list 2 3 1
Battery Impedance
FaradayRF Power Supply Filtering
Performance could change with battery impedance
Reference  Faraday Lowest Input Impedance
