FaradayRF/FaradayRF-Hardware/EngineeringDocs/VCCFiltering.asc

C1: cap; 1µ; Rser=10m
C2: cap; 18p; Rser=10m
L1: FerriteBead; 64n; Ipk=3 Rser=0.04 Rpar=56 Cpar=197f mfg="Wurth Elektronik" pn="742 792 112"
L2: FerriteBead; 64n; Ipk=3 Rser=0.04 Rpar=56 Cpar=197f mfg="Wurth Elektronik" pn="742 792 112"
R1: res; 40
R2: res; 1m
V1: voltage; ""; AC 1
Named nets: 0
.ac oct 100 1Meg 1G
300mA Operation @12V
VCC impedance
FaradayRF VCC Filtering
