FaradayRF/FaradayRF-Hardware/(commit log)

2016-10-16 Added Faraday Rev B files and cleaned up the libraries .lib and .mod. Both schematics and PCB projects appear to run ERC and DRC fine! Removed unecessary engineering documents too.
    [ADC12CALCS.xlsx, ADC_Filters.sch, AN5142-link-budget.xls, CC430.sch, Crystal_Calculations.xlsx, FLASH.sch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]
2016-10-18 Added .gitignore for real this time. Also updated project schematics to include TAPR OHL V1.0 notice and Rev C marking. Added a CHANGES.txt and CONTRIB.txt per the TAPR OHL.
    [ADC_Filters.sch, CC430.sch, FLASH.sch, Faraday.sch, GPS.sch, MOSFET.sch, PowerSupply.sch, RF_Front_End.sch]
2016-10-18 Updated several items from the Rev B to C updates including microphone RC filter and CC1190 inductor footprints.
    [ADC_Filters.sch, CC430.sch, FLASH.sch, Faraday.sch, GPS.sch, MOSFET.sch, PowerSupply.sch, RF_Front_End.sch]
2016-10-19 Adding oscilloscope captures from 5V USB power testing
2016-10-20 Updated circuit to remove R7 and populate C15 and U11 for USB power up control. Also updated LTSpice simulation file and imported a new netlist to the PCB project file.
    [ADC_Filters.sch, CC430.sch, FLASH.sch, Faraday.kicad_pcb, Faraday.sch, GPS.sch, MOSFET.sch, PowerSupply.sch]
2016-10-20 Per work on FaradayRF-Hardware Issue #1 I incorporated L10 as an 0603 package and moved the standby net underneath the CC430 which caused copper to be pulled back on the exposed pad.
    [Faraday.kicad_pcb]
2016-10-23 Added new FaradayRF and OSHW logos to the PCB layout. Also updated some revision text and moved the Faraday name with revision to the front of the board.
    [ADC_Filters.sch, CC430.sch, FLASH.sch, Faraday.kicad_pcb, Faraday.sch, GPS.sch, MOSFET.sch, PowerSupply.sch]
2016-10-24 Updated OSHW and Faraday logos on schematics. Matched up logos on schematics to PCB component logos. Removed traces to old R7 resistor.
    [ADC_Filters.sch, CC430.sch, FLASH.sch, Faraday.kicad_pcb, Faraday.sch, GPS.sch, MOSFET.sch, PowerSupply.sch]
2016-10-24 CRemoved reference to FaradayRF.lib
    [ADC_Filters.sch, CC430.sch, FLASH.sch, Faraday.sch, GPS.sch, MOSFET.sch, PowerSupply.sch, RF_Front_End.sch]
2016-10-24 Updated BOM .csv and added a REV C BOM Excel document as well as Rev C ICD Excel document. Updated PCB layout file to include P3 and P4 swaps for GD0 changes per GitHub Hardware IT #6.
    [CC430.sch, Faraday-REVC(BOM).xlsx, Faraday.csv, Faraday.kicad_pcb, Faraday.sch, ICD_REV_C.xlsx]
2016-10-24 Updated PDF plot of schematics and included updated .gitignore
2016-10-24 Updated Rev C BOM with latest parts. Still need to source a fewfrom vendors
    [Faraday-REVC(BOM).xlsx]
2016-10-25 Finalizing PCB design with Hardware Issue #1 closed at this commit. All items addressed and some traces pushed over for GPIO and RF IO signals but overall minor
    [Faraday.kicad_pcb]
2016-10-26 Fixed L10 soldermask error and first attempt at Rev c output files.
    [Faraday-B_Cu.gbl, Faraday-B_Mask.gbs, Faraday-B_Paste.gbp, Faraday-B_SilkS.gbo, Faraday-Dwgs_User.gbr, Faraday-Eco1_User.gbr, Faraday-Eco2_User.gbr, Faraday-Edge_Cuts.gbr]
2016-10-26 Reverted pcb file error when GIT tried to merge the text in the PCB design file... argh. Also updated gerbers
    [Faraday-B_Cu.gbl, Faraday-B_Mask.gbs, Faraday-B_Paste.gbp, Faraday-B_SilkS.gbo, Faraday-Dwgs_User.gbr, Faraday-Eco1_User.gbr, Faraday-Eco2_User.gbr, Faraday-Edge_Cuts.gbr]
2016-10-26 Removing Faraday Rev C folder from commits, adding to gitignore next. will only keep zip file.
    [Faraday-B_Cu.gbl, Faraday-B_Mask.gbs, Faraday-B_Paste.gbp, Faraday-B_SilkS.gbo, Faraday-Dwgs_User.gbr, Faraday-Eco1_User.gbr, Faraday-Eco2_User.gbr, Faraday-Edge_Cuts.gbr]
2016-10-26 Removing staging folder for Gerbers from git repo control.
2016-10-26 Cleaned up CC1190 section from encroaching grounds. Verified all layers against Rev B
    [Faraday-B_Cu.gbl, Faraday-B_Mask.gbs, Faraday-B_Paste.gbp, Faraday-B_SilkS.gbo, Faraday-Dwgs_User.gbr, Faraday-Eco1_User.gbr, Faraday-Eco2_User.gbr, Faraday-Edge_Cuts.gbr]
2016-10-27 Checked DNPs
    [Faraday-REVC(BOM).xlsx]
2016-10-27 Huge update with new Faraday.mod library instead of KB1LQC.mod due to new footprints in Rev B and C not showing up in KB1LQC.mod... Created final output gerbers for single PCB and made pick and place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
    [Faraday-B_Cu.gbl, Faraday-B_Mask.gbs, Faraday-B_Paste.gbp, Faraday-B_SilkS.gbo, Faraday-Dwgs_User.gbr, Faraday-Eco1_User.gbr, Faraday-Eco2_User.gbr, Faraday-Edge_Cuts.gbr]
2016-10-30 Updated RF 50 Ohm and 100 Ohm traces to be appropriately sized for Advanced Circuits manufacturing stackup (standard). Also pulled away groundplanes from RF traces to keep microstrip impedance correc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
    [Faraday.kicad_pcb]
2016-10-30 Checked all Rev C gerbers and they appear fine for 1-up AC work, gerbers now include updates for 50 Ohm and 100 Ohm AC stackup trace widths.
    [Faraday-B_Cu.gbl, Faraday-B_Mask.gbs, Faraday-B_Paste.gbp, Faraday-B_SilkS.gbo, Faraday-Dwgs_User.gbr, Faraday-Eco1_User.gbr, Faraday-Eco2_User.gbr, Faraday-Edge_Cuts.gbr]
2016-10-30 Added Read.Me file for Advanced Circuits and included it in the Fabrication zip file.
2016-10-30 Added BOM assembly count information to BOM Excel file.
    [Faraday-REVC(BOM).xlsx]
2016-11-02 Removed quote from drawing layer that was causing Macrofab kicad file parser error.
    [Faraday.kicad_pcb]
2016-11-10 Updated per RevD Github Issue comments. Largely removed unnecessary items
    [ADC_Filters.sch, CC430.sch, FLASH.sch, Faraday.sch, GPS.sch, MOSFET.sch, PowerSupply.sch, RF_Front_End.sch]
2016-11-10 Pulled in netlist to PCB file. Still missing diodes
    [Faraday.kicad_pcb]
2016-11-11 Added new NXP diode array and imported netlist rerouting until no errors left. Still need to redo stackup impedance traces and grounding fences that were removed.
    [ADC_Filters.sch, CC430.sch, FLASH.sch, Faraday.kicad_pcb, Faraday.sch, GPS.sch, MOSFET.sch, PowerSupply.sch]
2016-11-11 Reworked stackup for Macrofab. Need to wait on PCB.NG. STILL NEED TO DO GROUND FENCING
    [Faraday.kicad_pcb]
2016-11-13 Updated with ideal diode after realizing that the normal diodes have too large of a voltage drop... woops. Also added via fences back in.
    [ADC_Filters.sch, CC430.sch, FLASH.sch, Faraday.kicad_pcb, Faraday.sch, GPS.sch, MOSFET.sch, PowerSupply.sch]
2016-11-14 Saving current RevD, need ot export BOM
    [$GPS.sch, CC430.sch, PowerSupply.sch, RF_Front_End.sch]
2016-11-14 Adding Rev D files for night
    [$GPS.sch, ADC_Filters.sch, CC430.sch, FLASH.sch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]
2016-11-15 Cleaned up a few connections on the schematic to make sure wire junctions were used. Also added a few notes such as LED color. Output new PDF of Schematics and updated Rev to Rev D1 for PCB:NG
    [ADC_Filters.sch, CC430.sch, FLASH.sch, Faraday.sch, GPS.sch, MOSFET.sch, PowerSupply.sch, RF_Front_End.sch]
2016-11-15 Updated notes for PDF schematic. Check PSU routing and seems OK
    [CC430.sch, Faraday.kicad_pcb, RF_Front_End.sch]
2016-11-16 Updated RF traces to have better pullback of about 50 mils for same layer copper pullback. Also updated Via Fencing. Work captured on Hardware Issue #31 on Github.
    [Faraday.kicad_pcb]
2016-11-16 Updated PCB text/reference designators/silkscreen per Github Hardware issue #29
    [Faraday.kicad_pcb]
2016-11-16 Checked fiducial and mousebite locations on Hardware Github issue #32
    [Faraday.kicad_pcb]
2016-11-16 Removed old rev c zip fabrication file. Created new gerbers and a new Rev d fabrication zip file. Also combined NPTH and plated TH drill files into faraday-all.drl. Updated read.me in fab zip file to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
    [ADC_Filters.sch, CC430.sch, FLASH.sch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]
2016-11-17 Updated after Rev C to Rev D changes review per Hardware Issue #33
    [Faraday-B_Cu.gbl, Faraday-B_Mask.gbs, Faraday-B_Paste.gbp, Faraday-B_SilkS.gbo, Faraday-Dwgs_User.gbr, Faraday-Eco1_User.gbr, Faraday-Eco2_User.gbr, Faraday-Edge_Cuts.gbr]
2016-11-17 Updated soldermask to allow global definition of 4 mils. Ended up on 4.1 mils on this board with still some more DFM issues to work though. Moved some of the reference designtors in the process...
    [Faraday-B_Cu.gbl, Faraday-B_Mask.gbs, Faraday-B_Paste.gbp, Faraday-B_SilkS.gbo, Faraday-Dwgs_User.gbr, Faraday-Eco1_User.gbr, Faraday-Eco2_User.gbr, Faraday-Edge_Cuts.gbr]
2016-11-17 Quick save for the morning. Lots of soldermask work with the QFN packages. Definitely need to revisit board ref des placement and such again and export clean gerbers/drill files!
    [Faraday-B_Cu.gbl, Faraday-B_Mask.gbs, Faraday-B_Paste.gbp, Faraday-B_SilkS.gbo, Faraday-Dwgs_User.gbr, Faraday-Eco1_User.gbr, Faraday-Eco2_User.gbr, Faraday-Edge_Cuts.gbr]
2016-11-18 Finished reviewing gerbers for errors like misplaced reference designators/silkscreen text and layer by layer stackup orientation.
    [Faraday-B_Cu.gbl, Faraday-B_Mask.gbs, Faraday-B_Paste.gbp, Faraday-B_SilkS.gbo, Faraday-Dwgs_User.gbr, Faraday-Eco1_User.gbr, Faraday-Eco2_User.gbr, Faraday-Edge_Cuts.gbr]
2016-11-18 I'm not superstitious, but I don't take chances! Decided to create a new netlist and pull it into the PCB and generate new gerbers to ensure nothing was accidentally missed
    [Faraday-B_Cu.gbl, Faraday-B_Mask.gbs, Faraday-B_Paste.gbp, Faraday-B_SilkS.gbo, Faraday-Dwgs_User.gbr, Faraday-Eco1_User.gbr, Faraday-Eco2_User.gbr, Faraday-Edge_Cuts.gbr]
2016-11-18 Exported new pick and place file
    [ADC_Filters.sch, CC430.sch, FLASH.sch, Faraday-REVC(BOM).xlsx, Faraday-REVD(BOM).xlsx, Faraday-all.xlsx, Faraday.csv, Faraday.sch]
2016-11-18 Updated rotation position file to include manufacturer numbers too
    [Faraday-all.xlsx]
2016-11-18 Created new assembly zip file with Rev D files
2016-11-18 Updated pick and place file with correct top/bottom markings as well as assembly zip update.
    [Faraday-all.xlsx]
2016-11-19 Removed mousebites and re-exported gerbers as well as drill files. Also realizes I didn't have the INSERT set for fiducials so I set that an exported XY position/rotation data for fiducials.
    [ADC_Filters.sch, CC430.sch, FLASH.sch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]
2016-11-20 updated pick and place files to work with PCB:NG better. Also exported gerbers and drill files relative to aux axis for PCB:NG.
    [Faraday-B_Cu.gbl, Faraday-B_Mask.gbs, Faraday-B_Paste.gbp, Faraday-B_SilkS.gbo, Faraday-Dwgs_User.gbr, Faraday-Eco1_User.gbr, Faraday-Eco2_User.gbr, Faraday-Edge_Cuts.gbr]
2016-11-20 Adding power test document from Reactance Labs help!
    [RF_Power_Test_RevB_11-19-2016.xlsx]
2016-11-21 Fixed up some cosmetic issues with silkscreen after reviewing gerbers with Brent @KB1LQD. Fixed an issue I found with the soldermask on pins 1 and 16 of the CC1190 so they used the global setting. La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
    [CC430.sch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]
2016-11-21 Quick save after last commit and pull request 41. This simply adds the csv pick and place to the zip assembly file.
2016-11-21 Update to pick and place file to remove comment plus removed erroneous flash chip from BOM
    [Faraday-REVD(BOM).xlsx, Faraday-all.csv, Faraday-all.xlsx]
